c4puter/motherboard/render/B_Cu.png

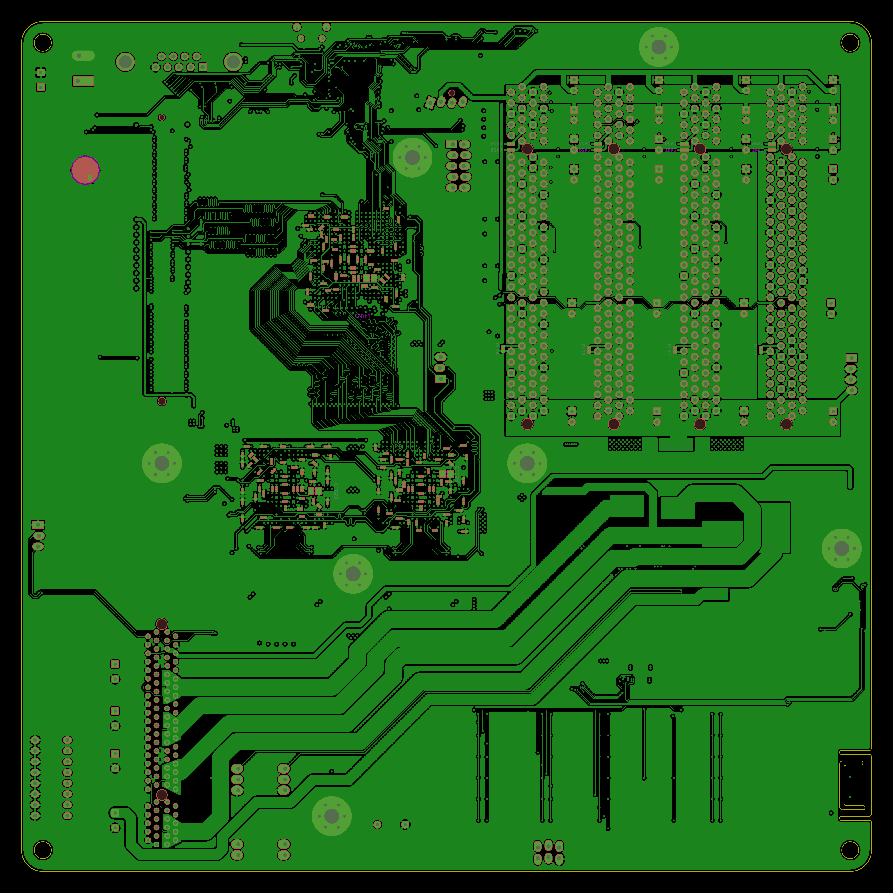
render/B_Cu.png
