c4puter/motherboard/render/F_Cu.png

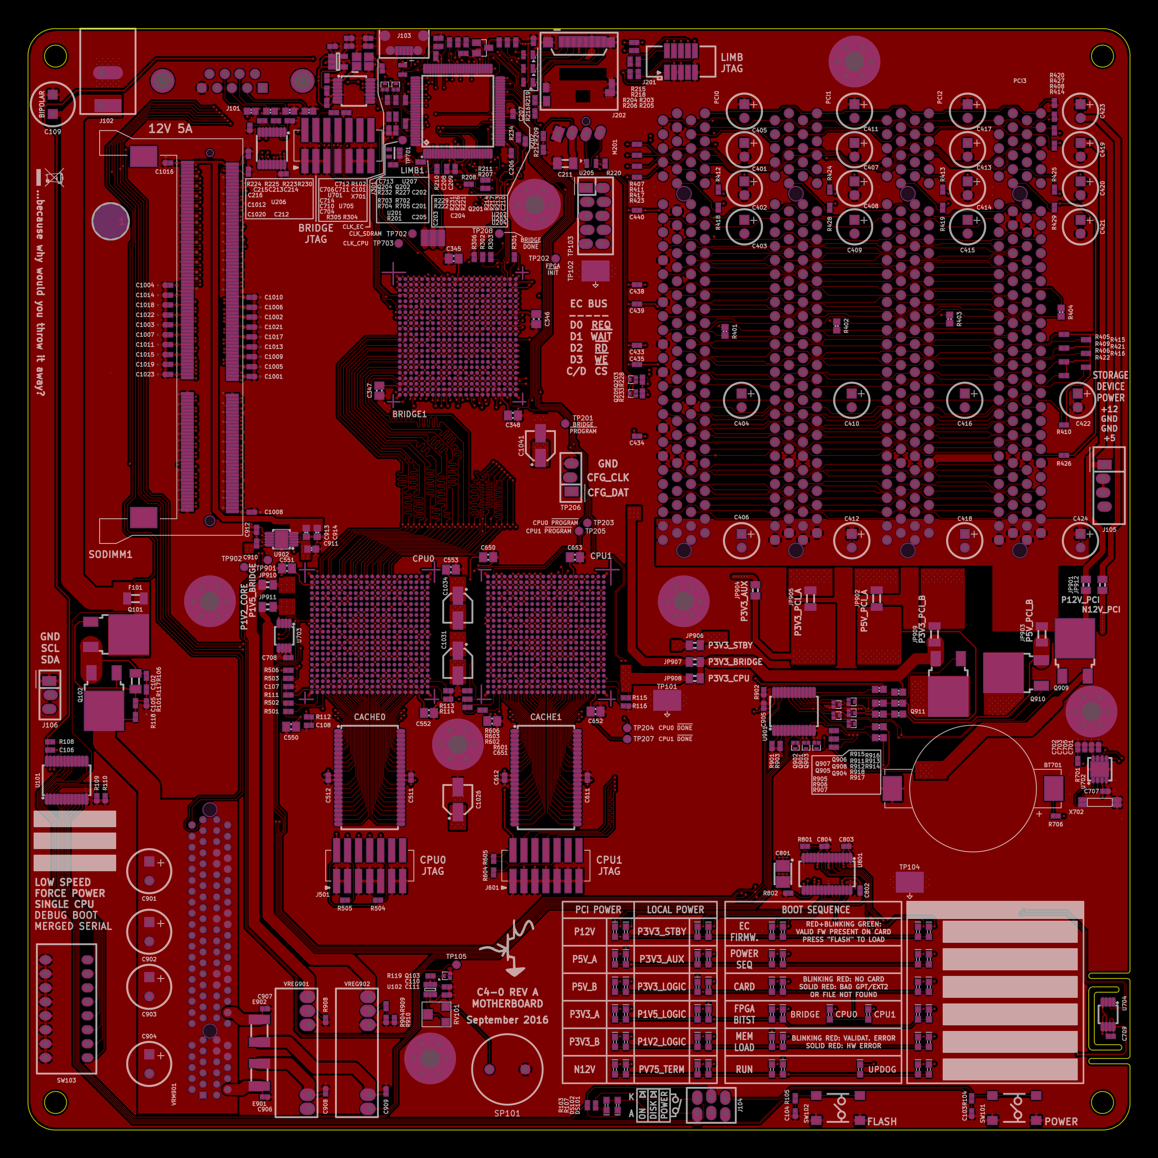
render/F_Cu.png
