c4puter/motherboard/render/In1_Cu.png

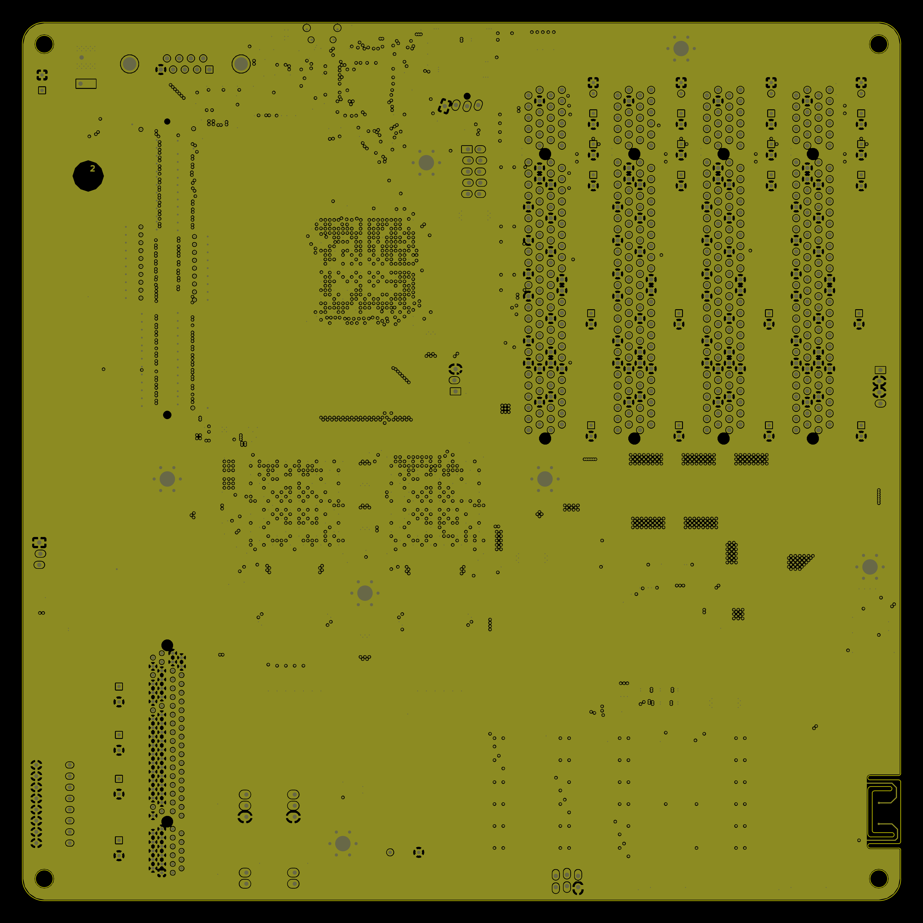
render/In1_Cu.png
