c4puter/motherboard/render/In2_Cu.png

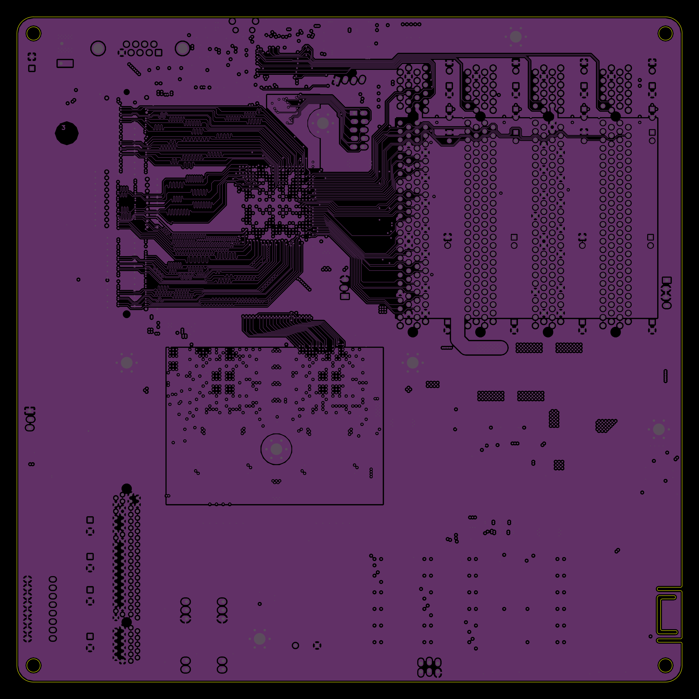
render/In2_Cu.png
