c4puter/motherboard/render/In3_Cu.png

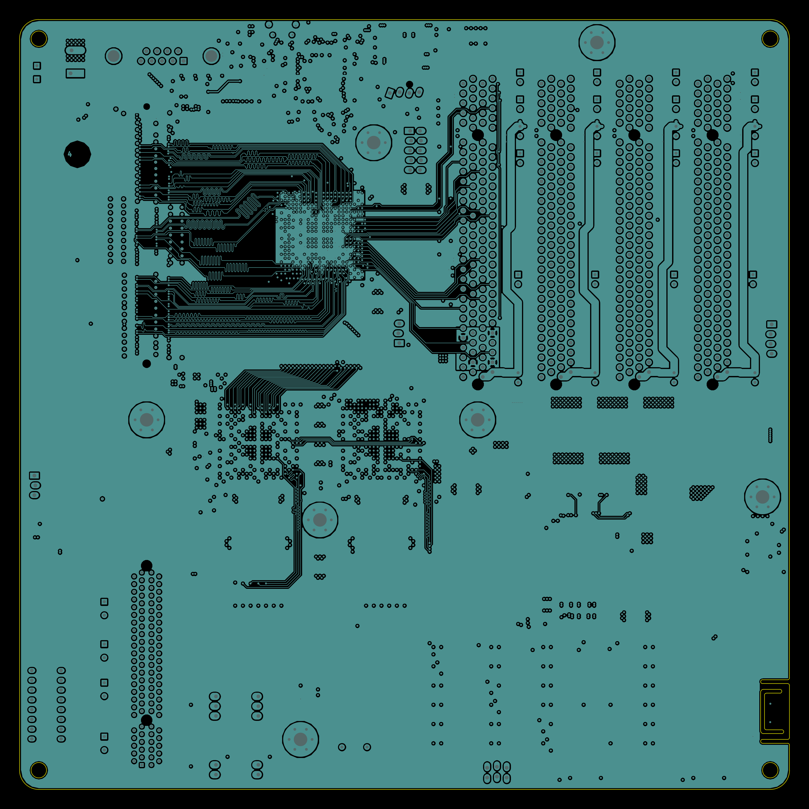
render/In3_Cu.png
