c4puter/motherboard/render/In4_Cu.png

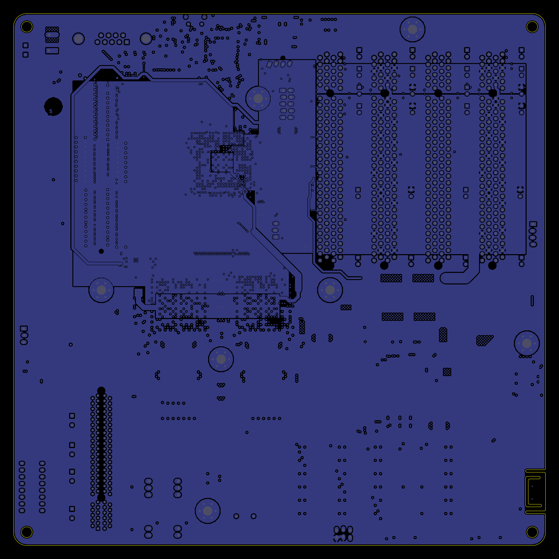
render/In4_Cu.png
