c4puter/motherboard/render/Overview.png

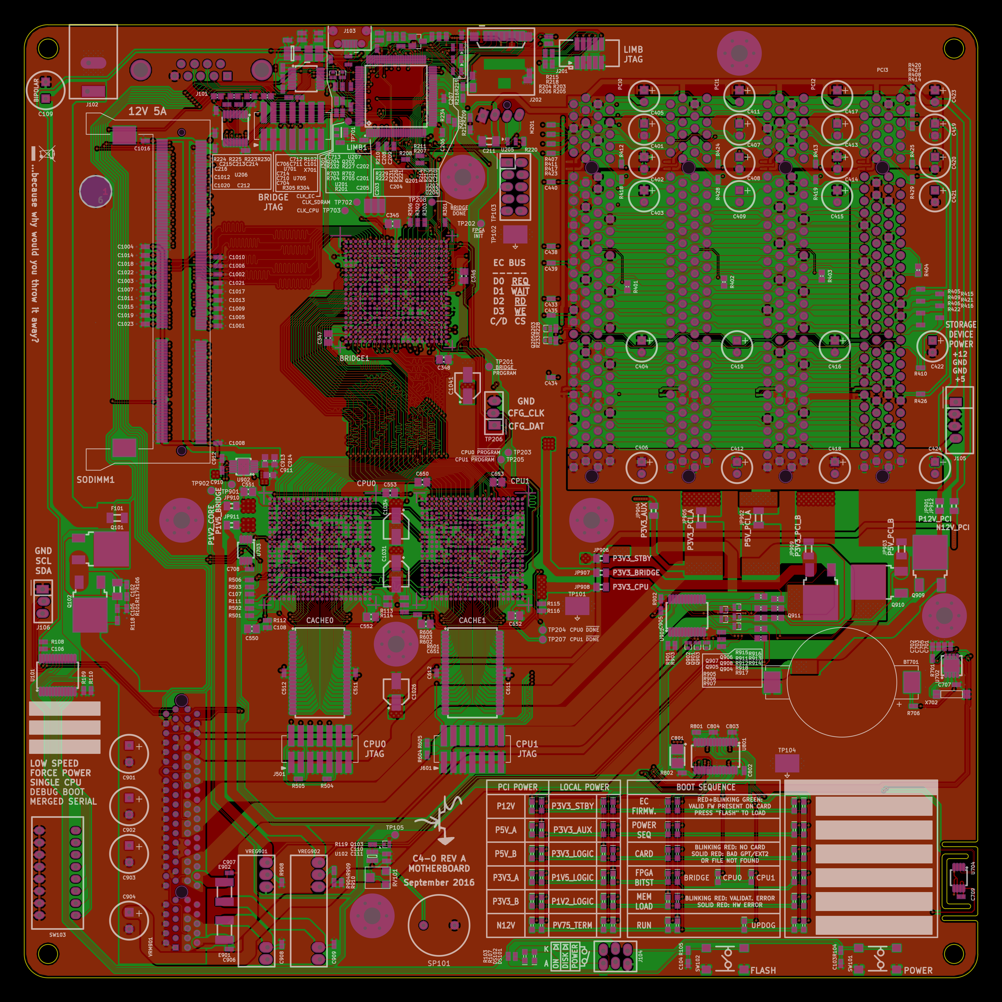
render/Overview.png
