c4puter/motherboard/motherboard.pdf

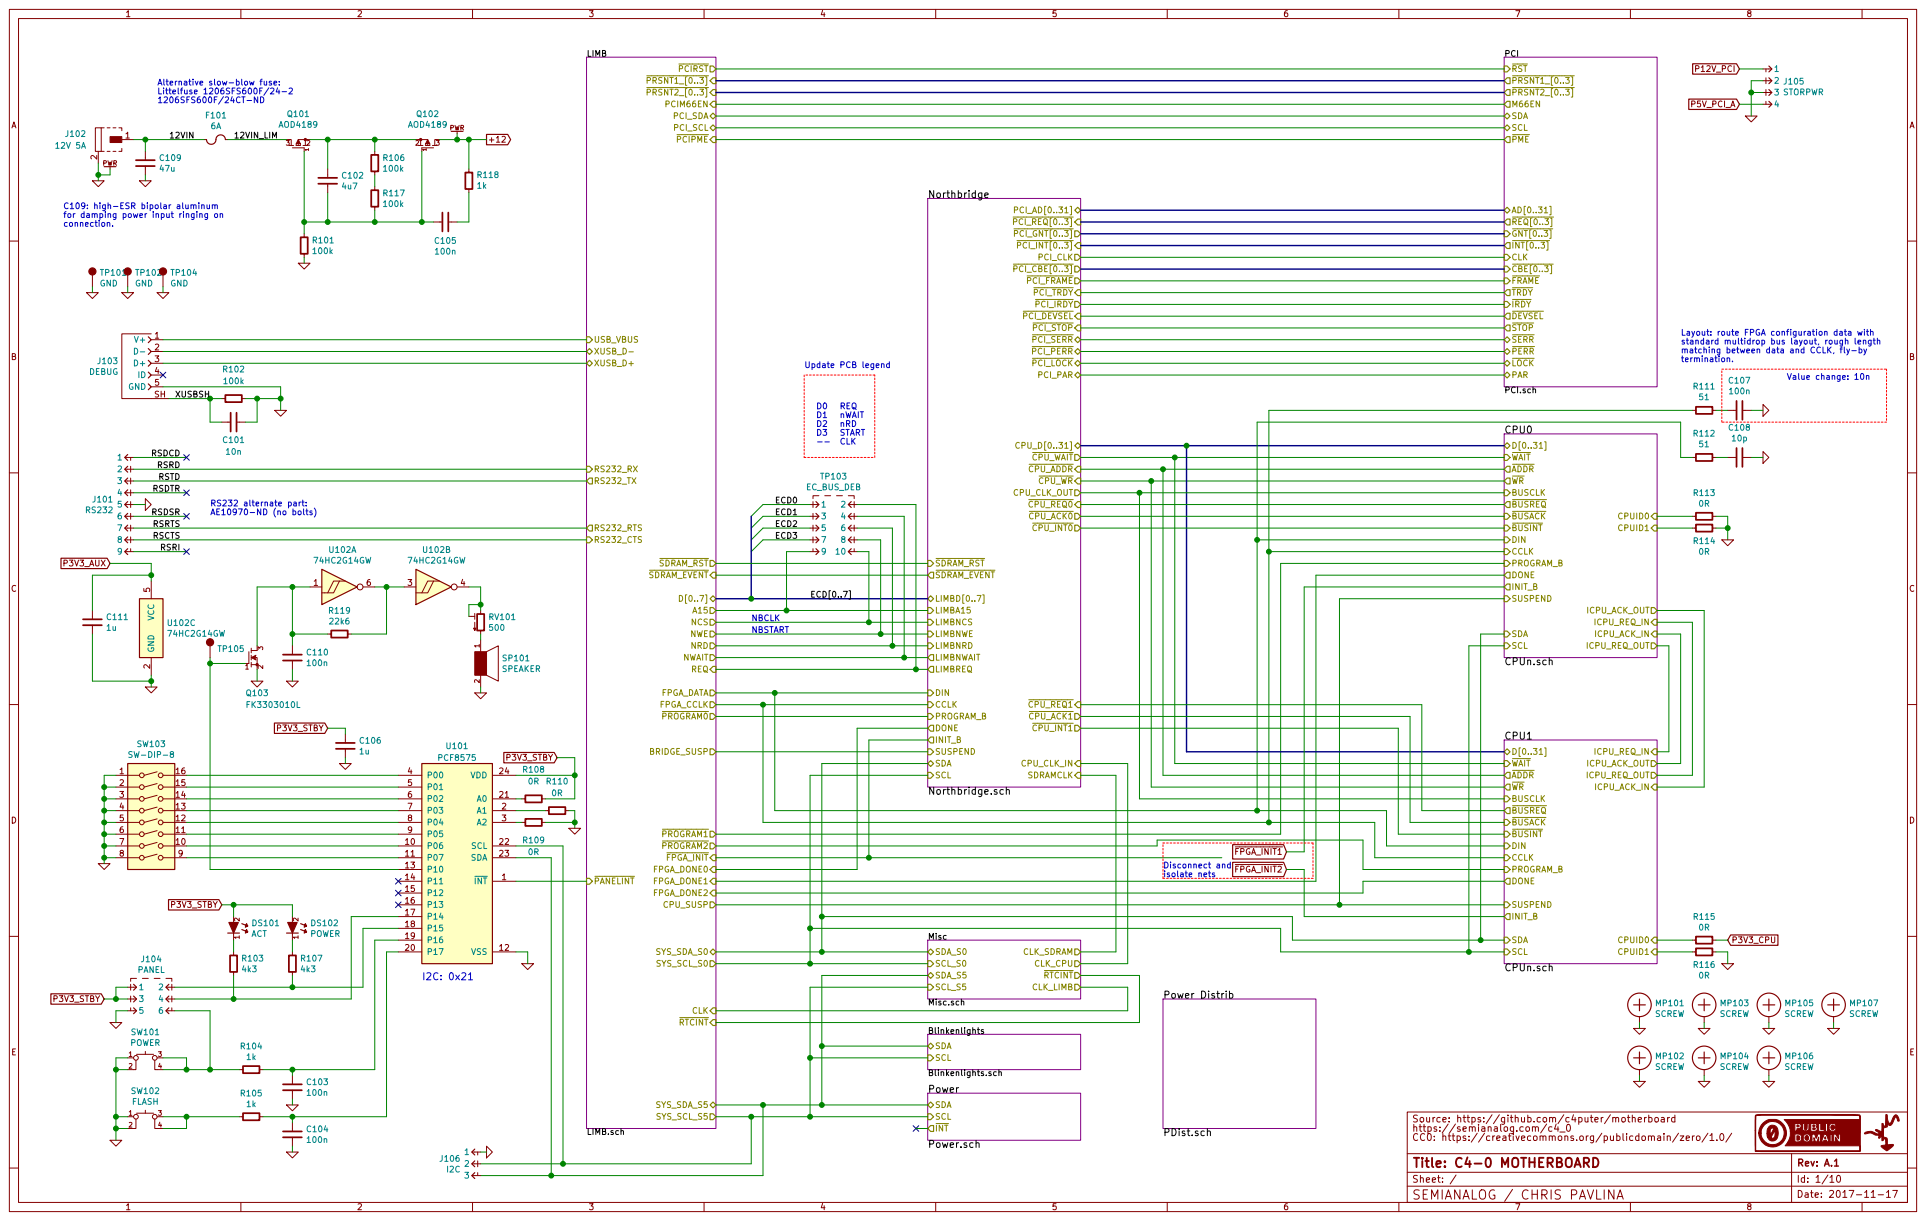
[picture p8: page 1]

PCI PCI.sch AD[0..31]
PRSNT2_[0..3] CLK RST PME CBE[0..3] FRAME
PRSNT1_[0..3]
SCL SDA M66EN CPU0

Alternative slow-blow fuse: Littelfuse 1206SFS600F/24-2
1206SFS600F/24CT-ND

47u C109: high-ESR bipolar aluminum

for damping power input ringing on

Layout: route FPGA configuration data with
standard multidrop bus layout, rough length
matching between data and CCLK, fly-by

START CLK Update PCB legend

15 | 0R 0R
14
13
12
11 | R109
10

Blinkenlights.sch SDA
SCL Power Power.sch

Source: https://github.com/c4puter/motherboard
https://semianalog.com/c4_0
Sheet: / CC0: https://creativecommons.org/publicdomain/zero/1.0/
Id: 1/10 Title: C4-0 MOTHERBOARD

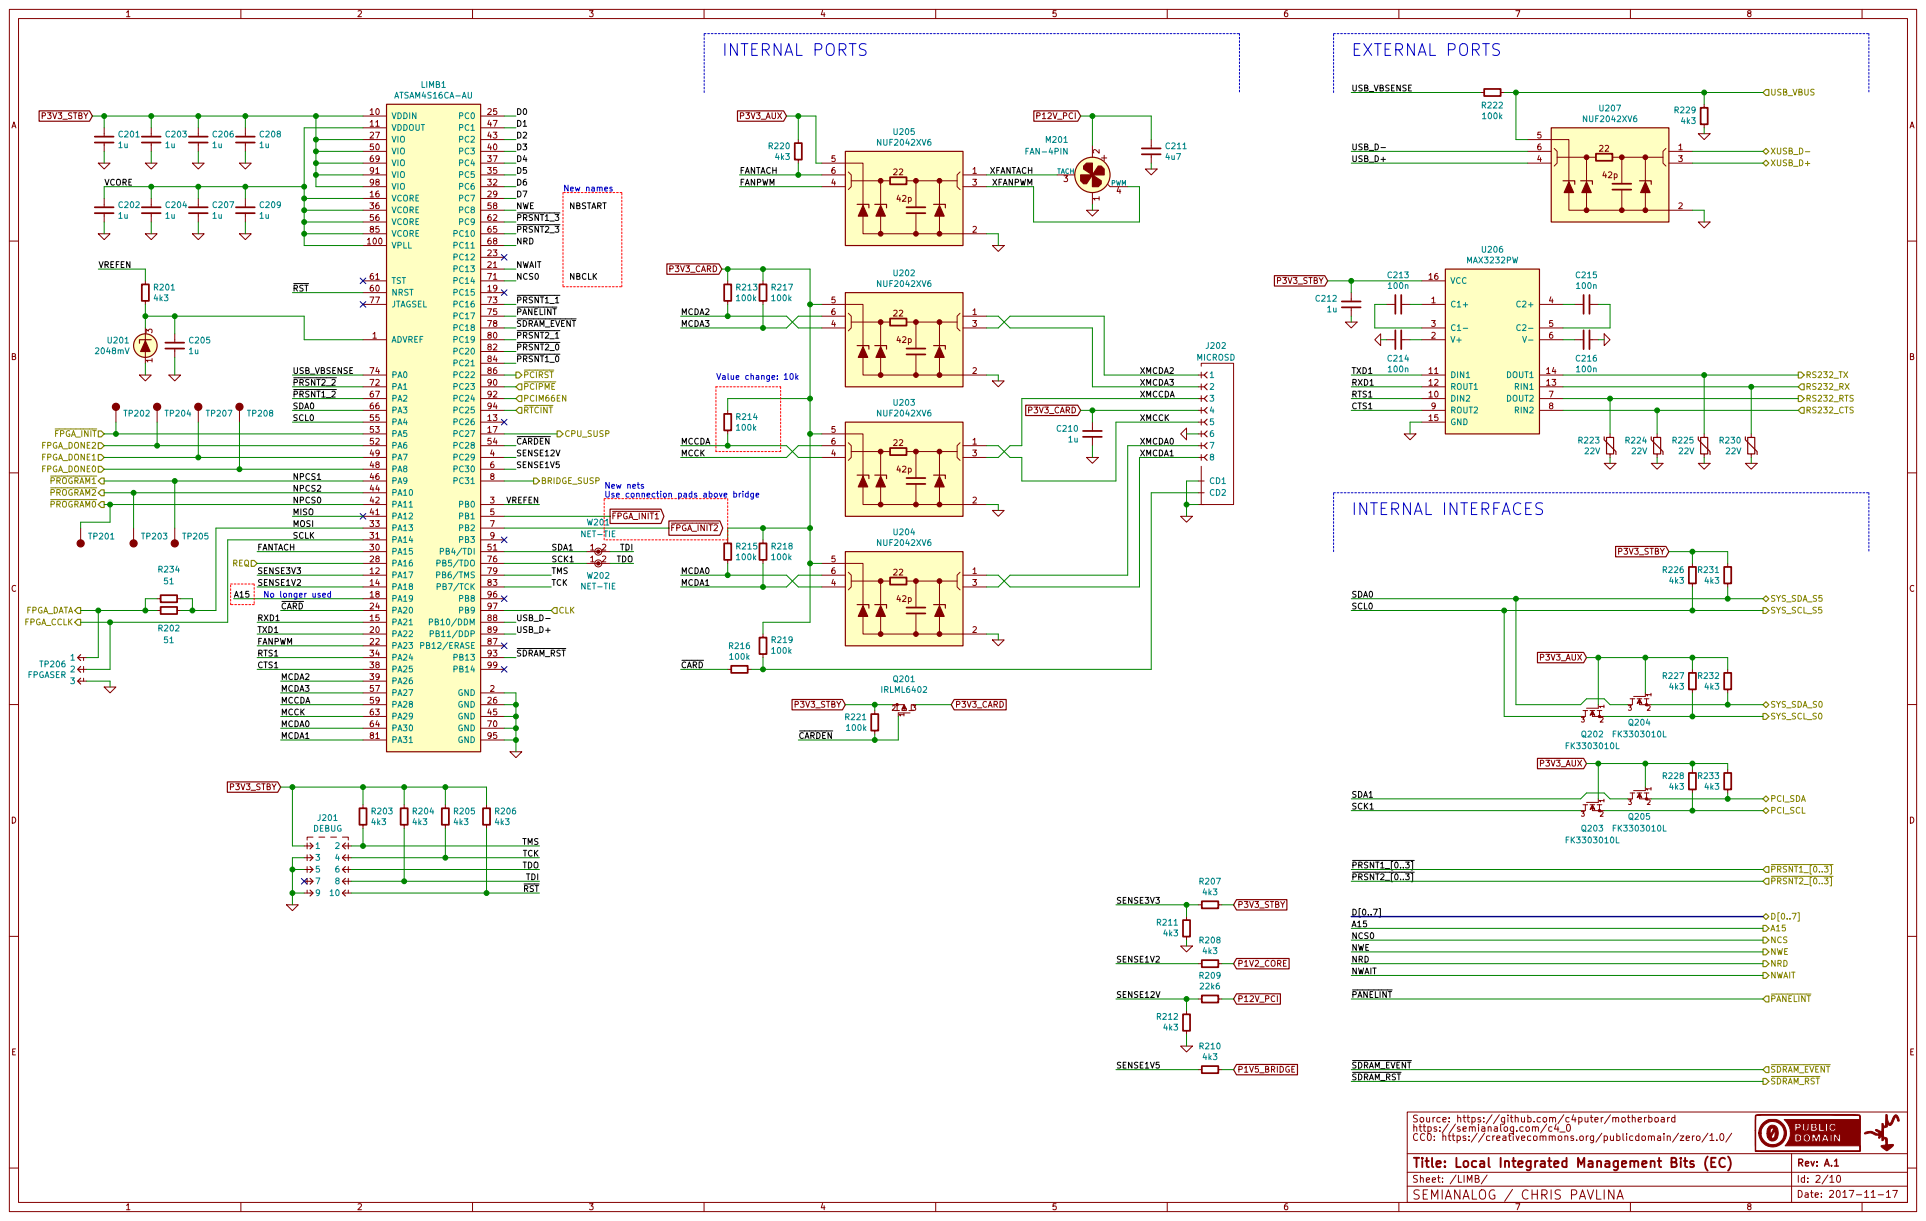
[picture p9: page 2]

Source: https://github.com/c4puter/motherboard
https://semianalog.com/c4_0
Id: 2/10 Title: Local Integrated Management Bits (EC) Sheet: /LIMB/ CC0: https://creativecommons.org/publicdomain/zero/1.0/

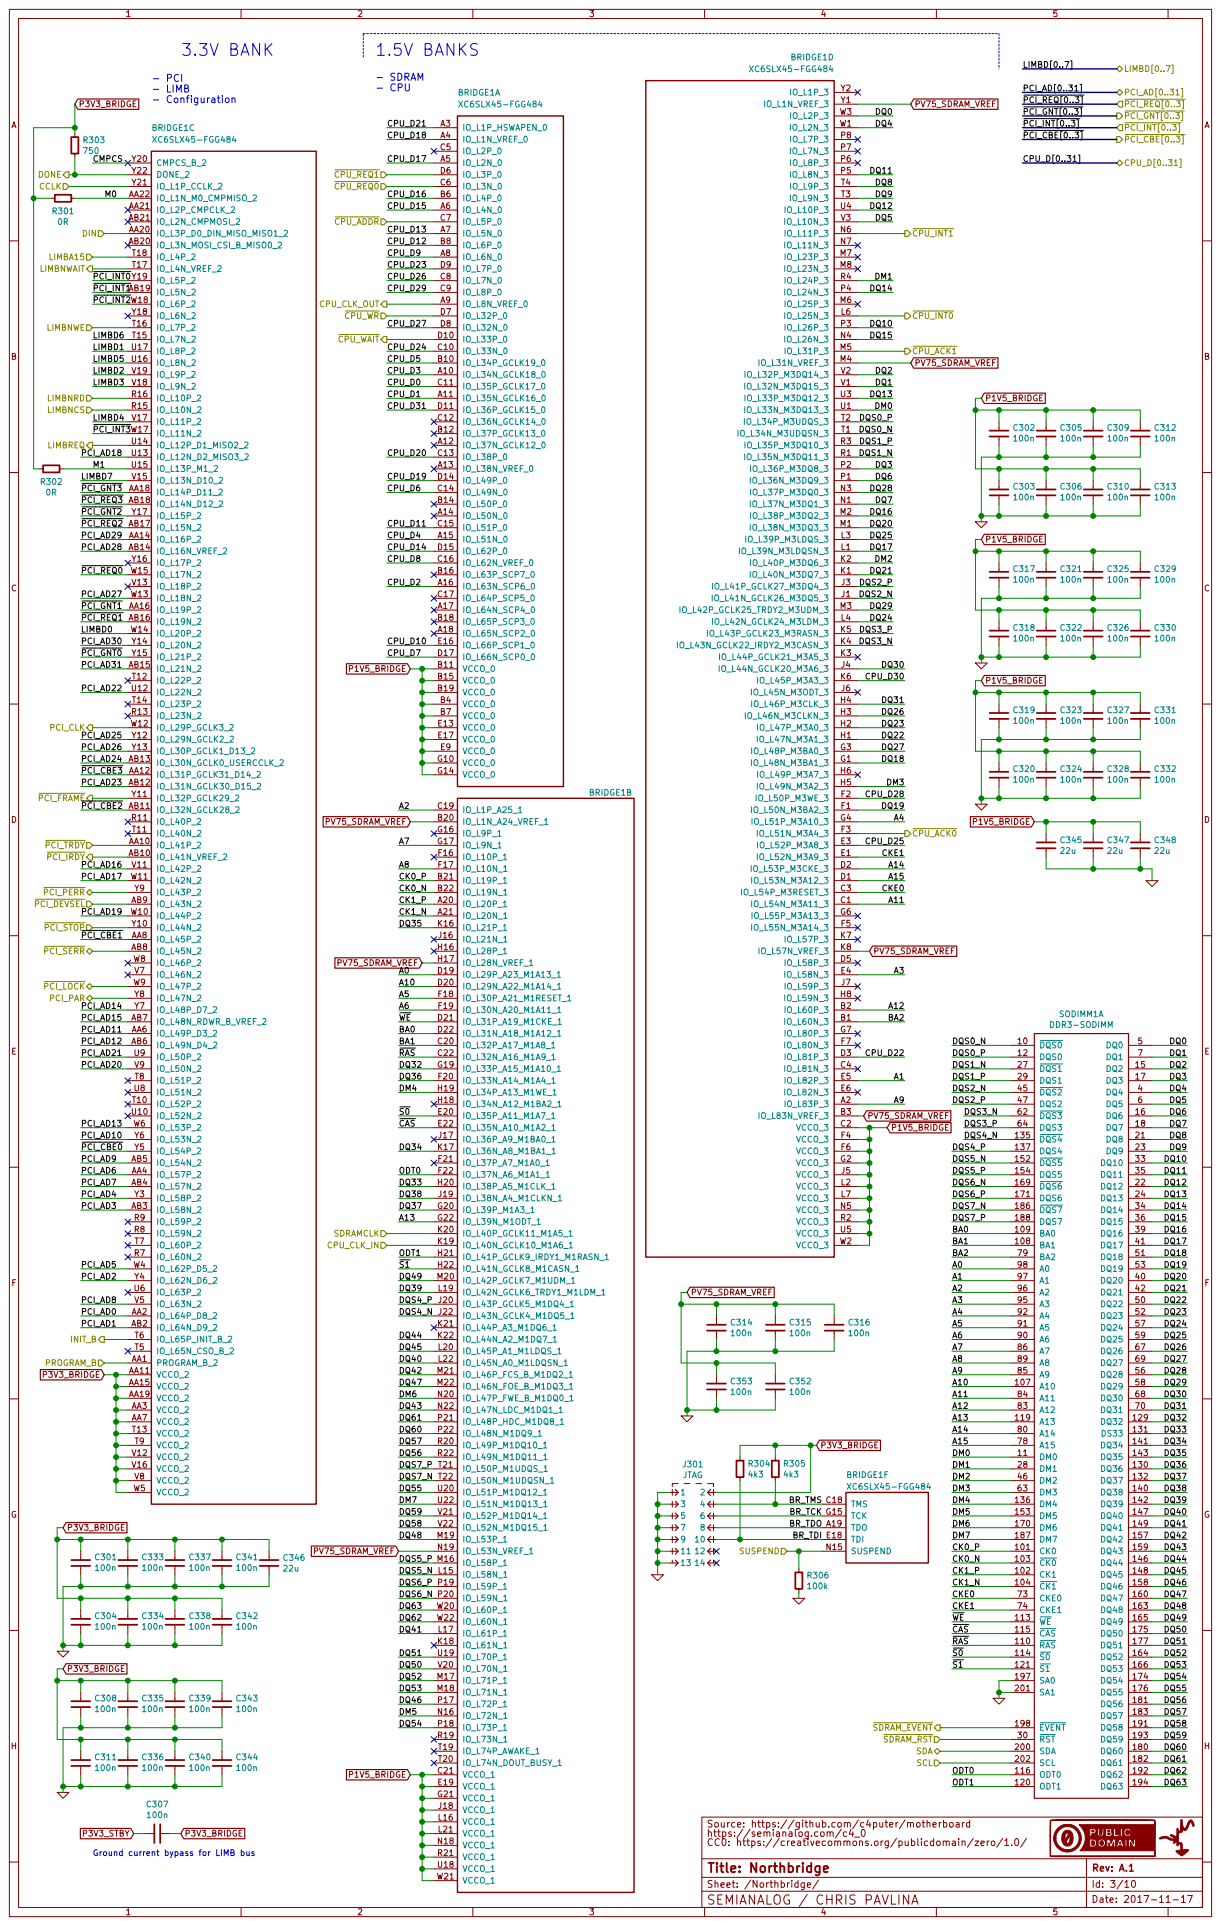
[picture p10: page 3]

TCK G15 SUSPEND N15 TMS C18 TDI E18 TDO A19 BRIDGE1F XC6SLX45-FGG484

Source: https://github.com/c4puter/motherboard
https://semianalog.com/c4_0

CC0: https://creativecommons.org/publicdomain/zero/1.0/
Id: 3/10 Title: Northbridge
Sheet: /Northbridge/

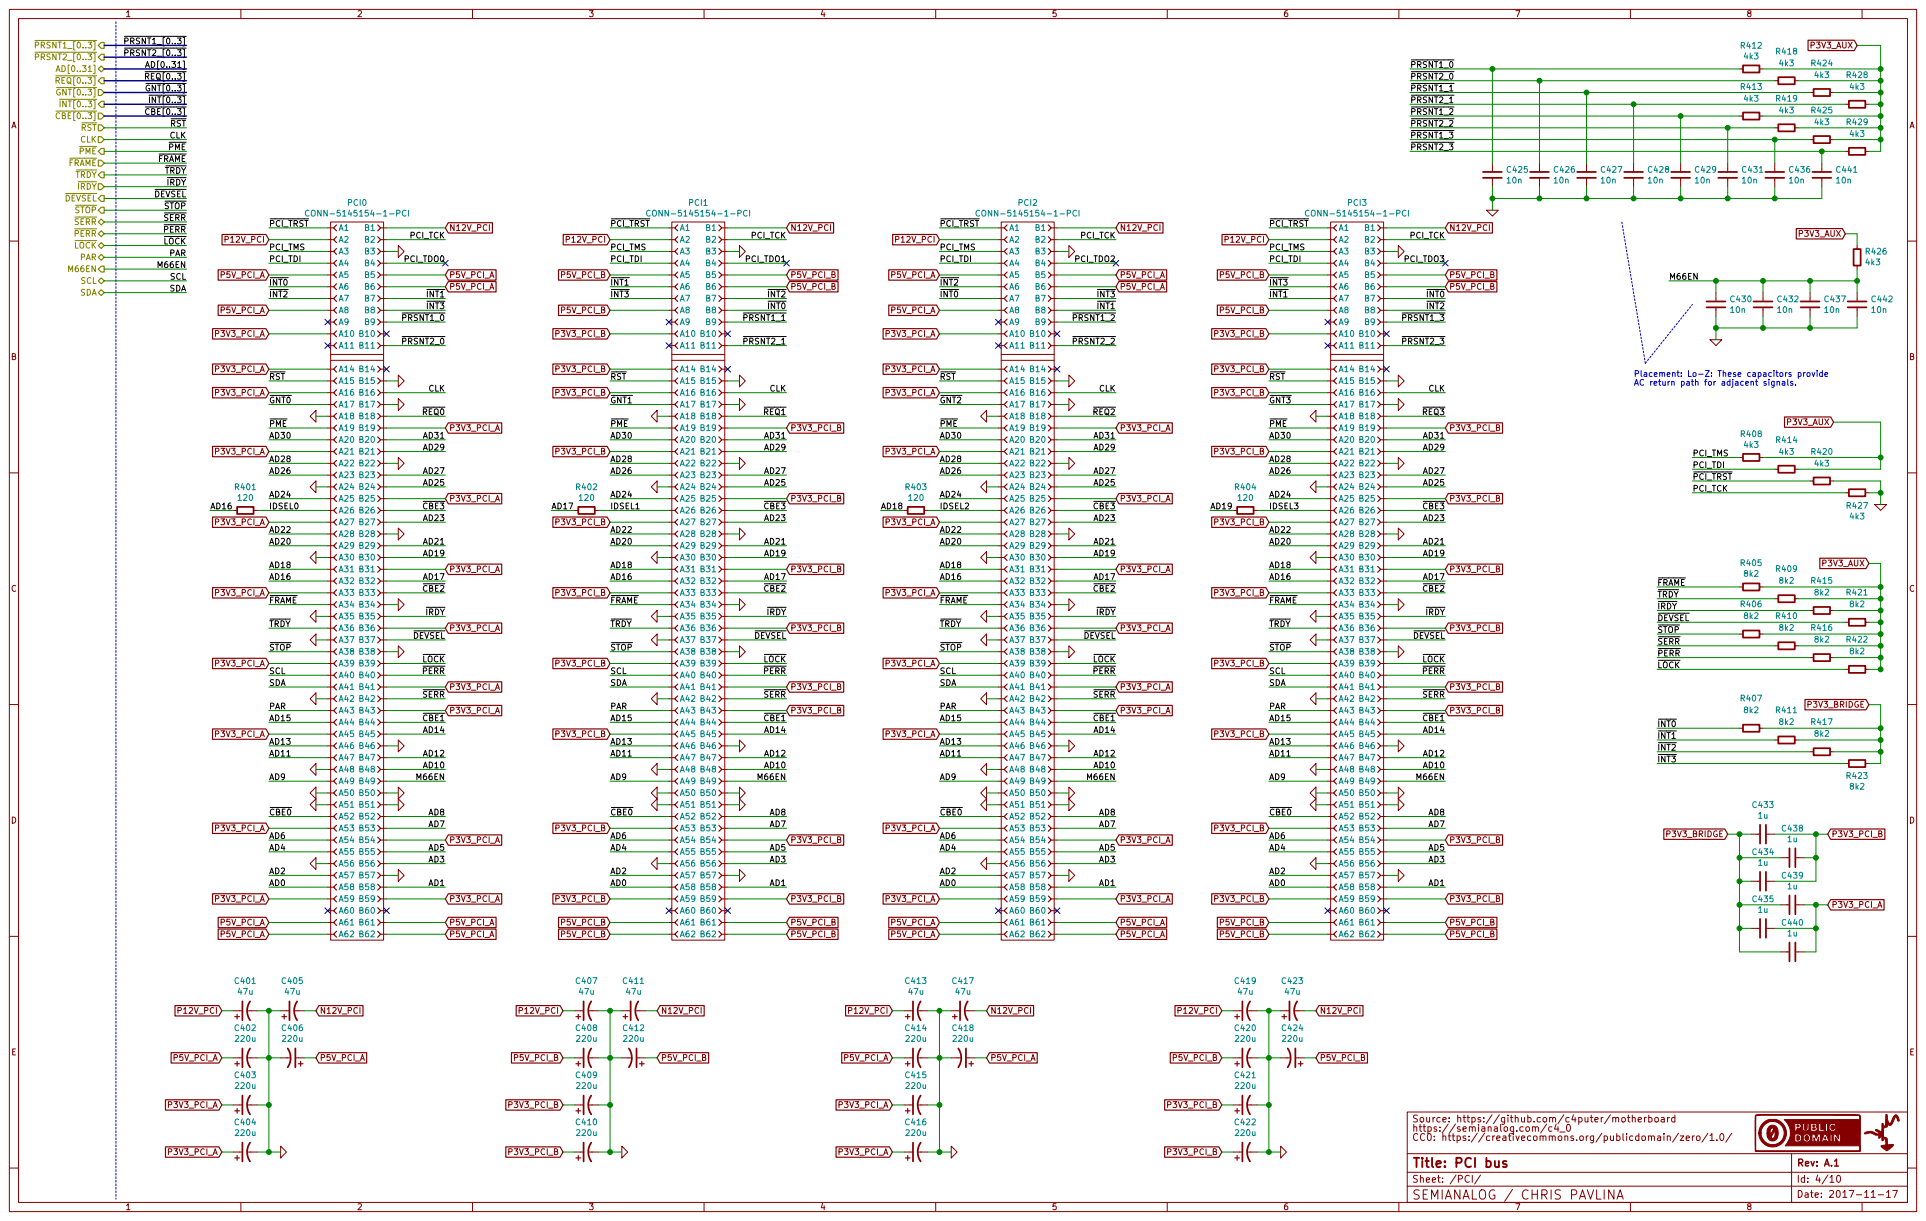
[picture p11: page 4]

P5V_PCI_B
AC return path for adjacent signals. C433

Placement: Lo-Z: These capacitors provide

Source: https://github.com/c4puter/motherboard
https://semianalog.com/c4_0
Sheet: /PCI/ CC0: https://creativecommons.org/publicdomain/zero/1.0/
Id: 4/10 Title: PCI bus

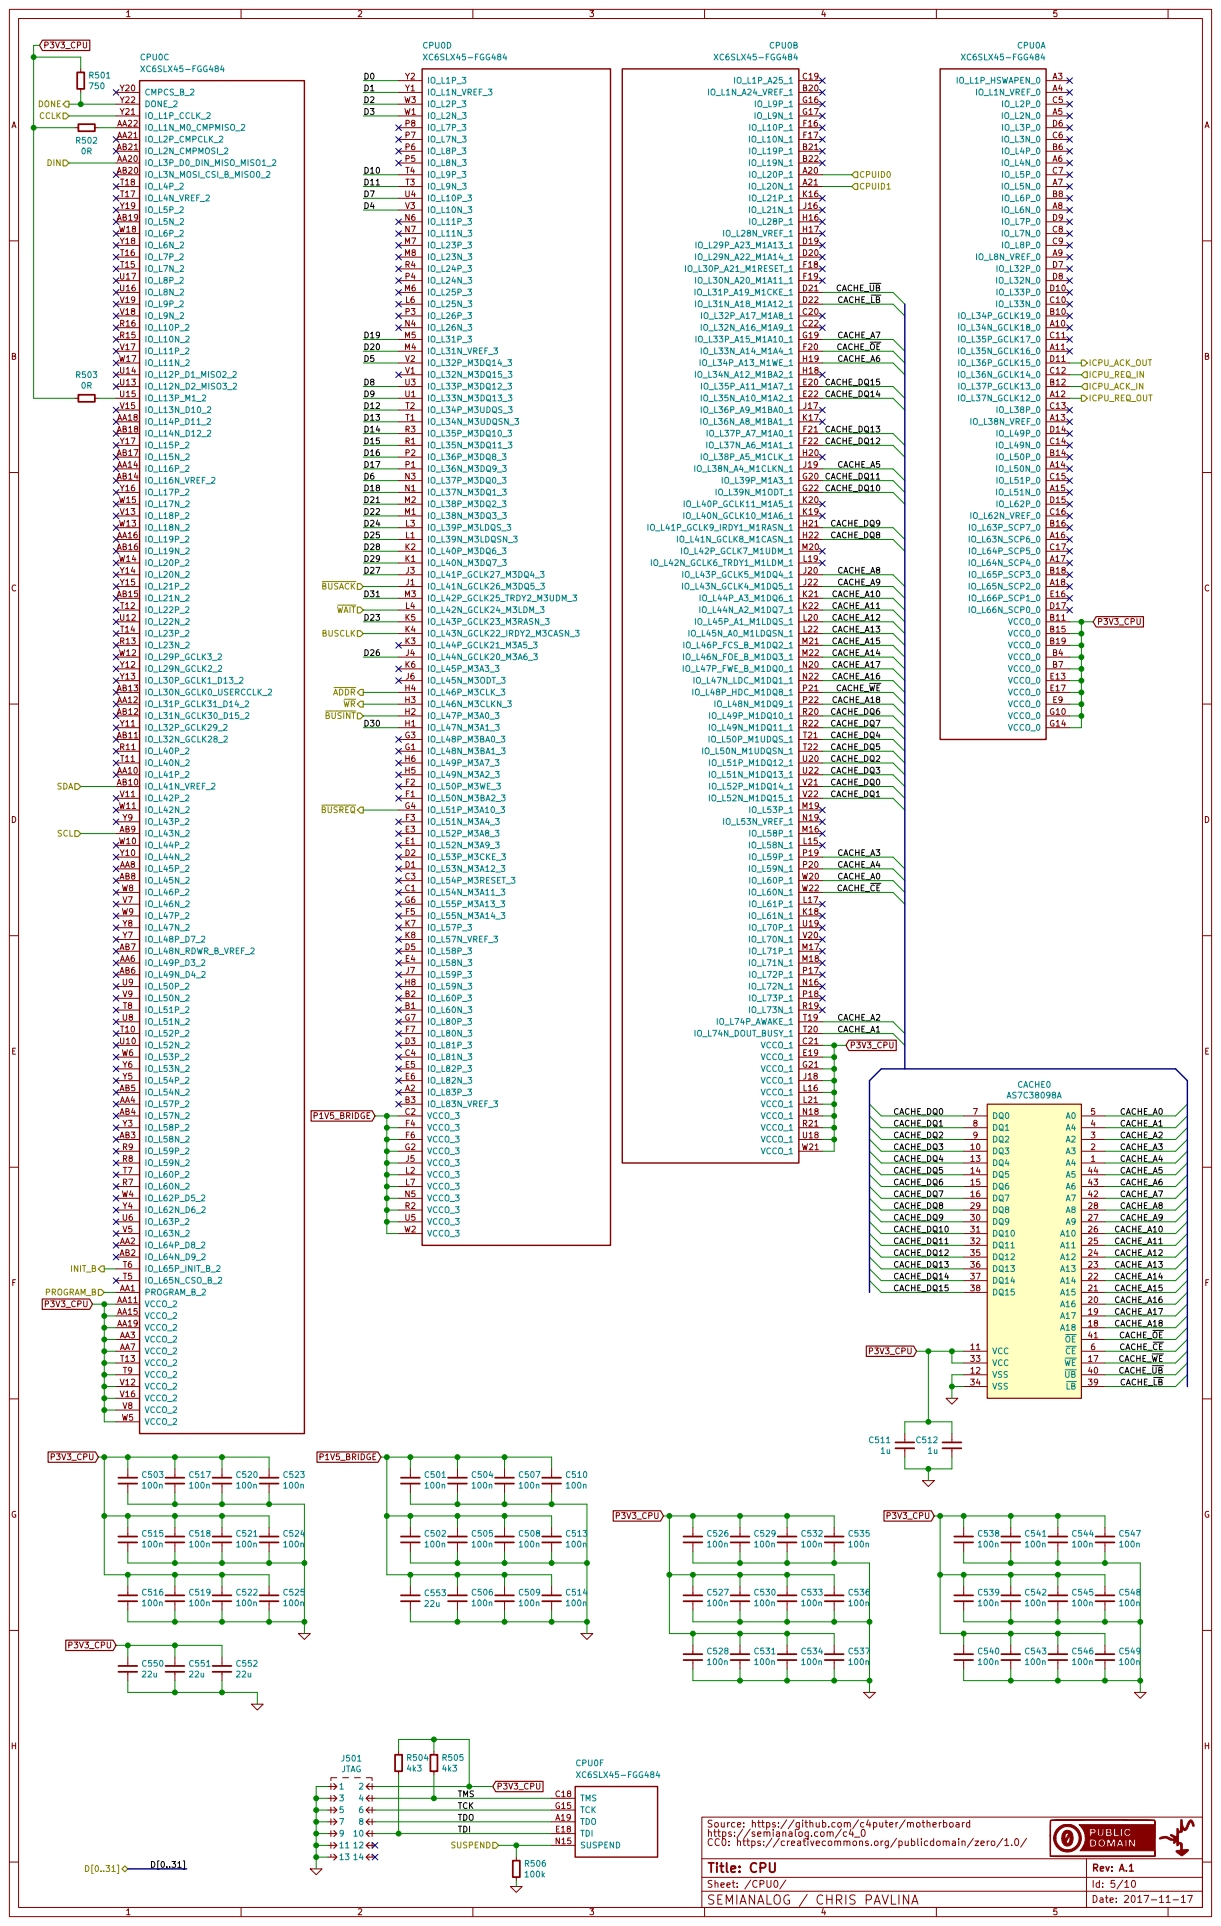
[picture p12: page 5]

Source: https://github.com/c4puter/motherboard
https://semianalog.com/c4_0
Sheet: /CPU0/ CC0: https://creativecommons.org/publicdomain/zero/1.0/
Id: 5/10 Title: CPU

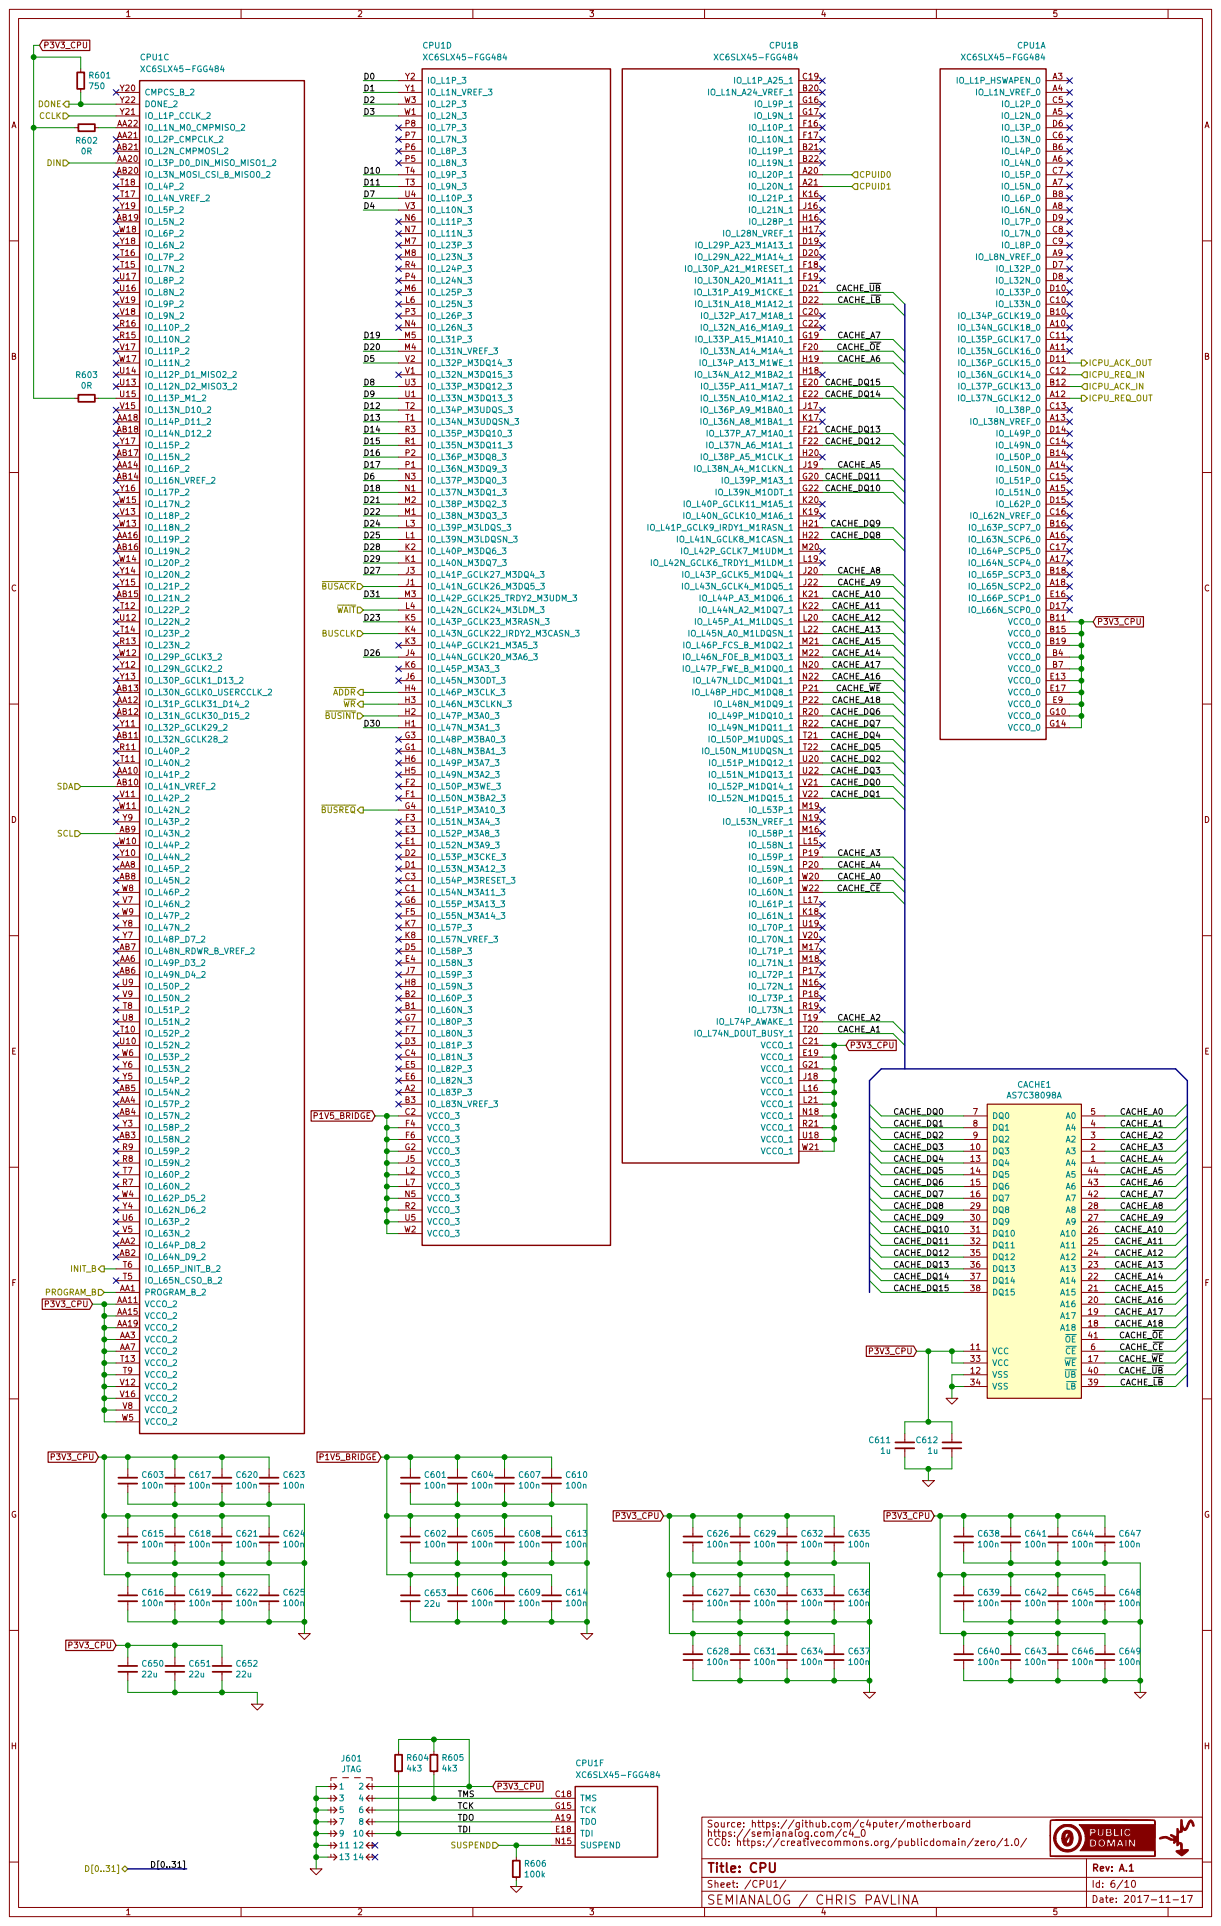
[picture p13: page 6]

Source: https://github.com/c4puter/motherboard
https://semianalog.com/c4_0
Sheet: /CPU1/ CC0: https://creativecommons.org/publicdomain/zero/1.0/
Id: 6/10 Title: CPU

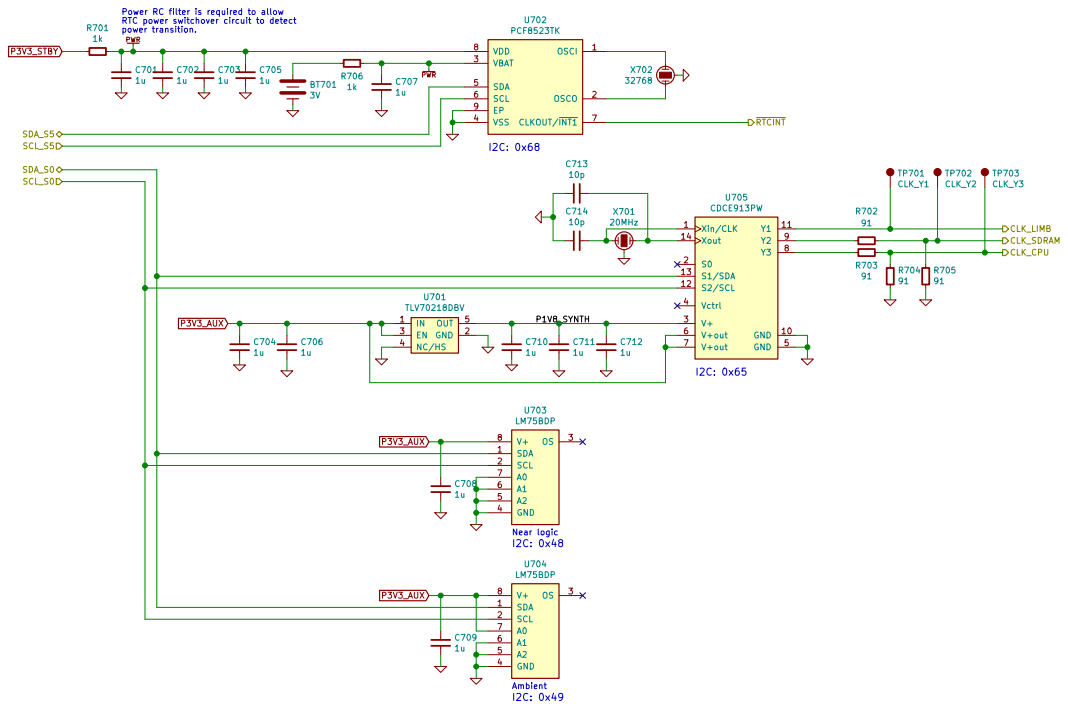
[picture p14: page 7]

Power RC filter is required to allow
RTC power switchover circuit to detect

Source: https://github.com/c4puter/motherboard
https://semianalog.com/c4_0
Sheet: /Misc/ CC0: https://creativecommons.org/publicdomain/zero/1.0/
Id: 7/10 Title: Miscellaneous peripherals

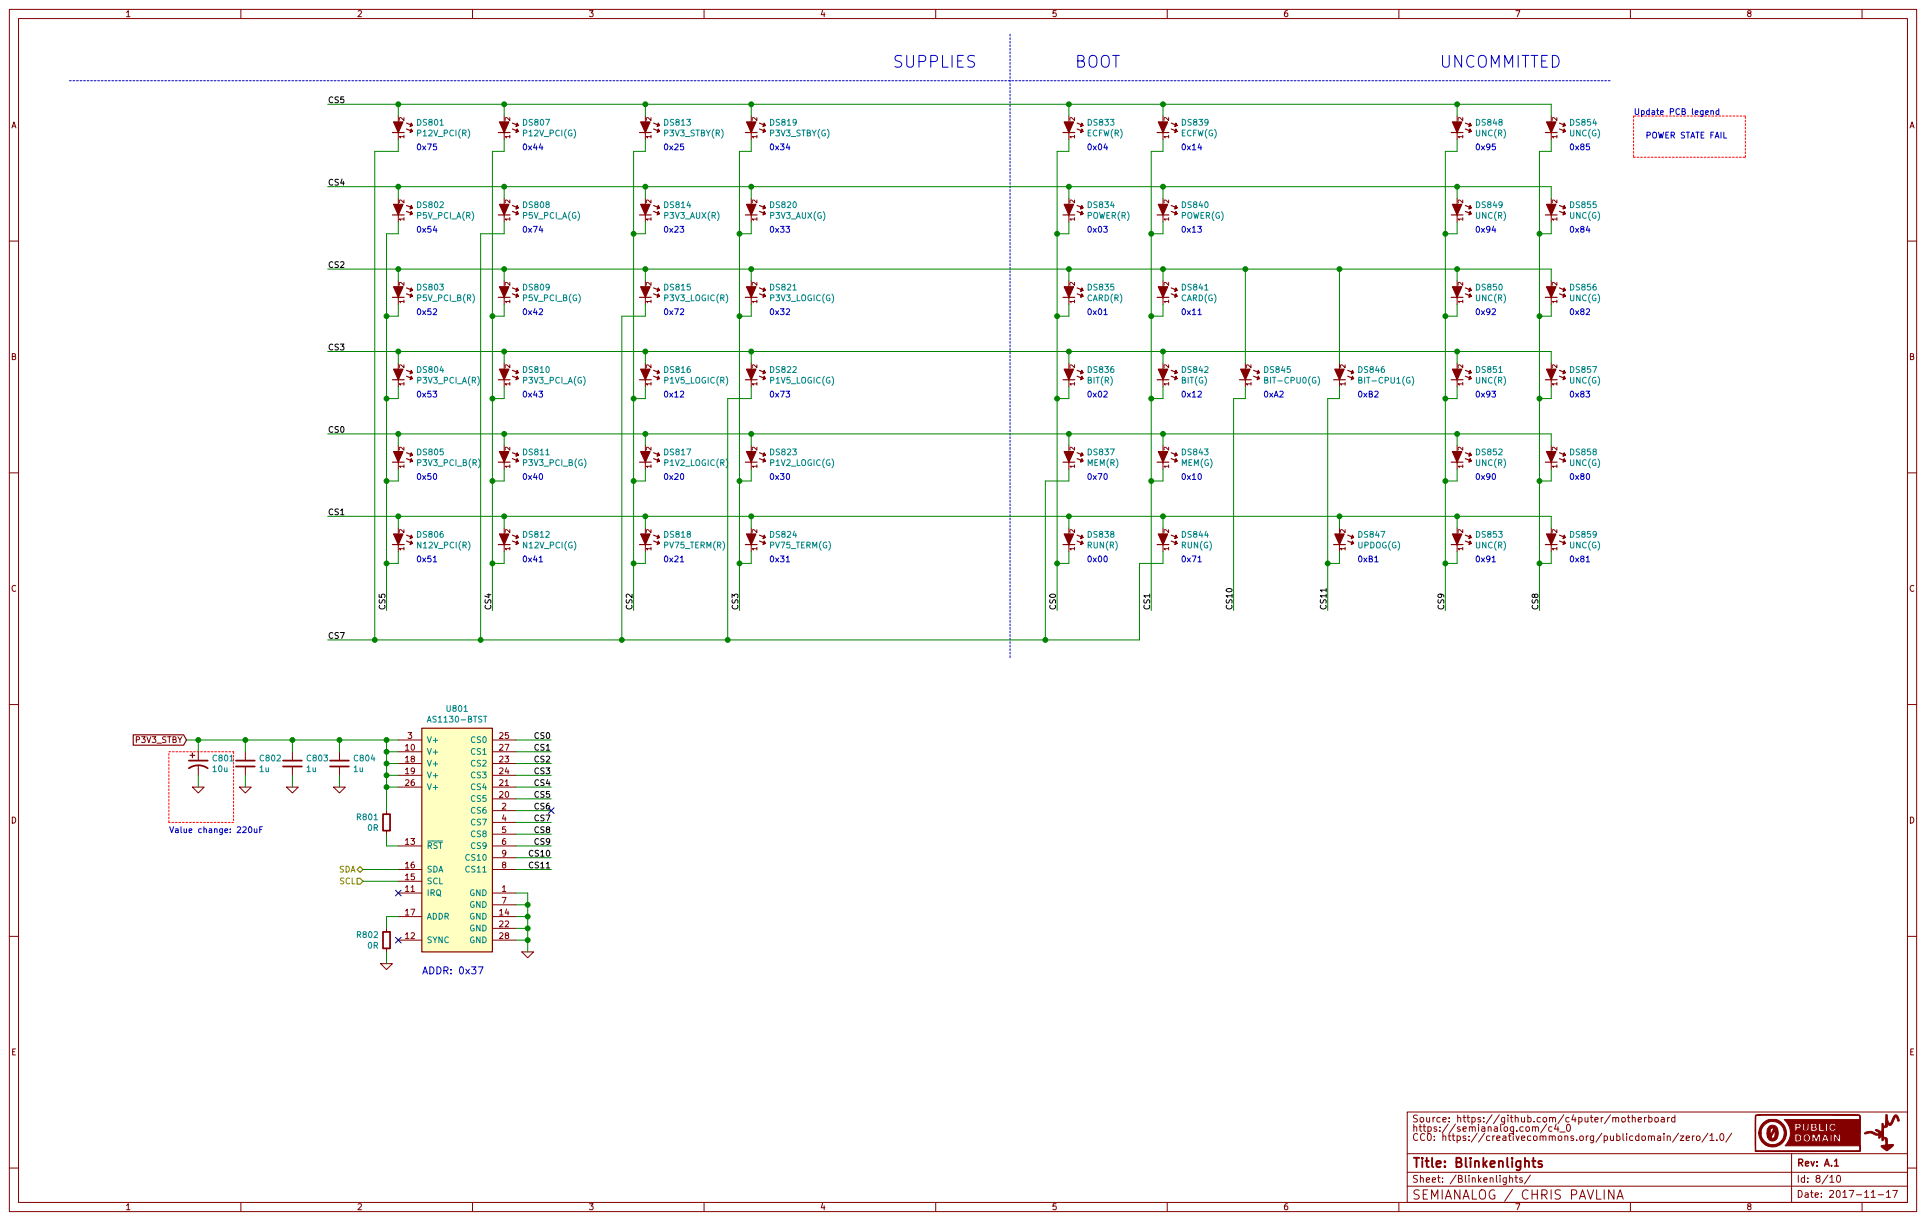
[picture p15: page 8]

POWER STATE FAIL Update PCB legend

1 2DS848 UNC(R) 1 2DS854 UNC(G) 1 2DS849 UNC(R) 1 2DS855 UNC(G) 1 2DS850 UNC(R) 1 2DS856 UNC(G) 1 2DS851 UNC(R) 1 2DS857 UNC(G) 1 2DS852 UNC(R) 1 2DS858 UNC(G) 1 2DS853 UNC(R) 1 2DS859 UNC(G) SDA

1 2DS833 ECFW(R) 1 2DS839 ECFW(G) 1 2DS834 POWER(R) 1 2DS840 POWER(G) 1 2DS835 CARD(R) 1 2DS841 CARD(G) 1 2DS845 BIT-CPU0(G) 1 2DS846 BIT-CPU1(G) 1 2DS836 BIT(R) 1 2DS842 BIT(G) 1 2DS837 MEM(R) 1 2DS843 MEM(G) 1 2DS847 UPDOG(G) 1 2DS838 RUN(R) 1 2DS844 RUN(G)

Source: https://github.com/c4puter/motherboard
https://semianalog.com/c4_0

CC0: https://creativecommons.org/publicdomain/zero/1.0/
Id: 8/10 Title: Blinkenlights
Sheet: /Blinkenlights/

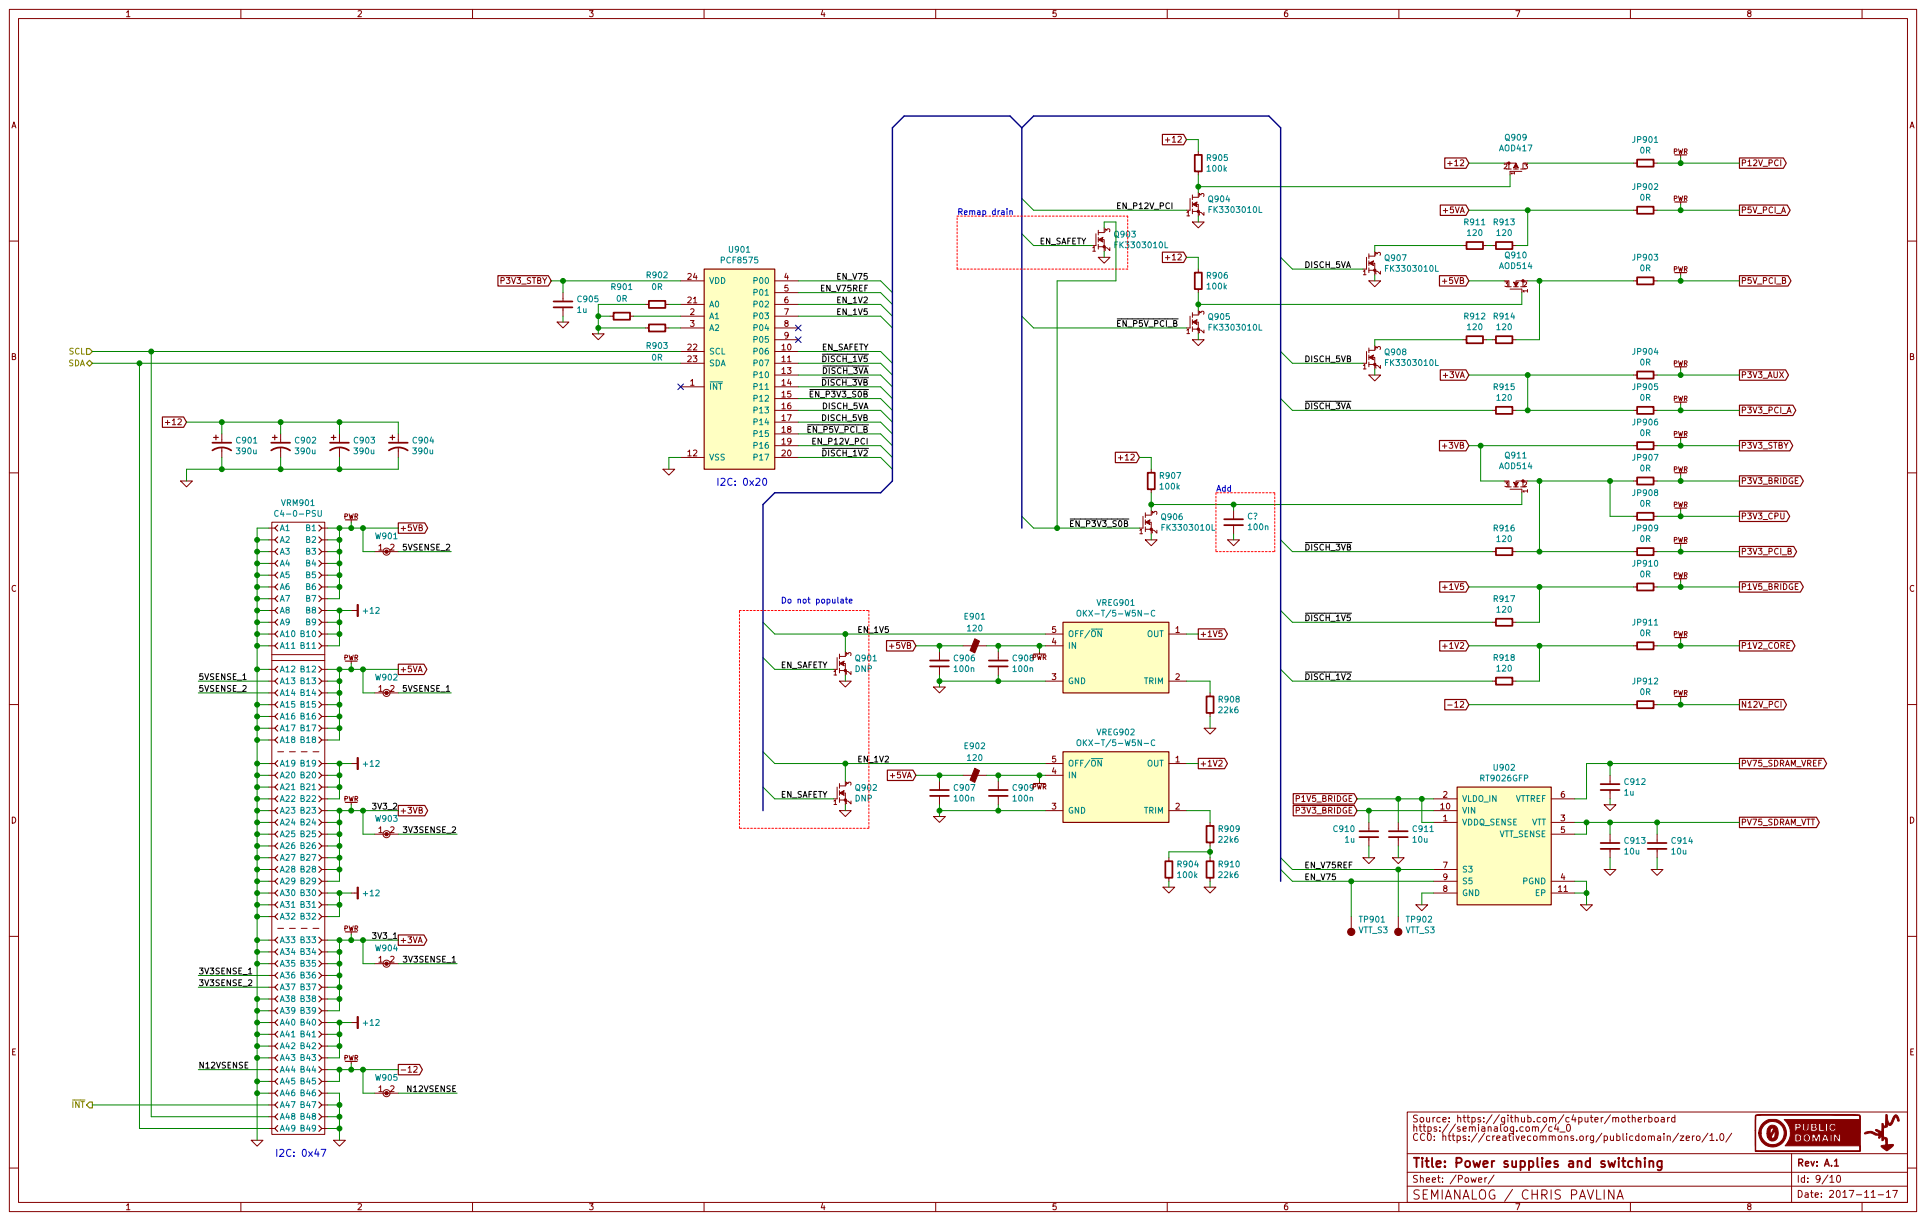
[picture p16: page 9]

Source: https://github.com/c4puter/motherboard
https://semianalog.com/c4_0
Sheet: /Power/ CC0: https://creativecommons.org/publicdomain/zero/1.0/
Id: 9/10 Title: Power supplies and switching

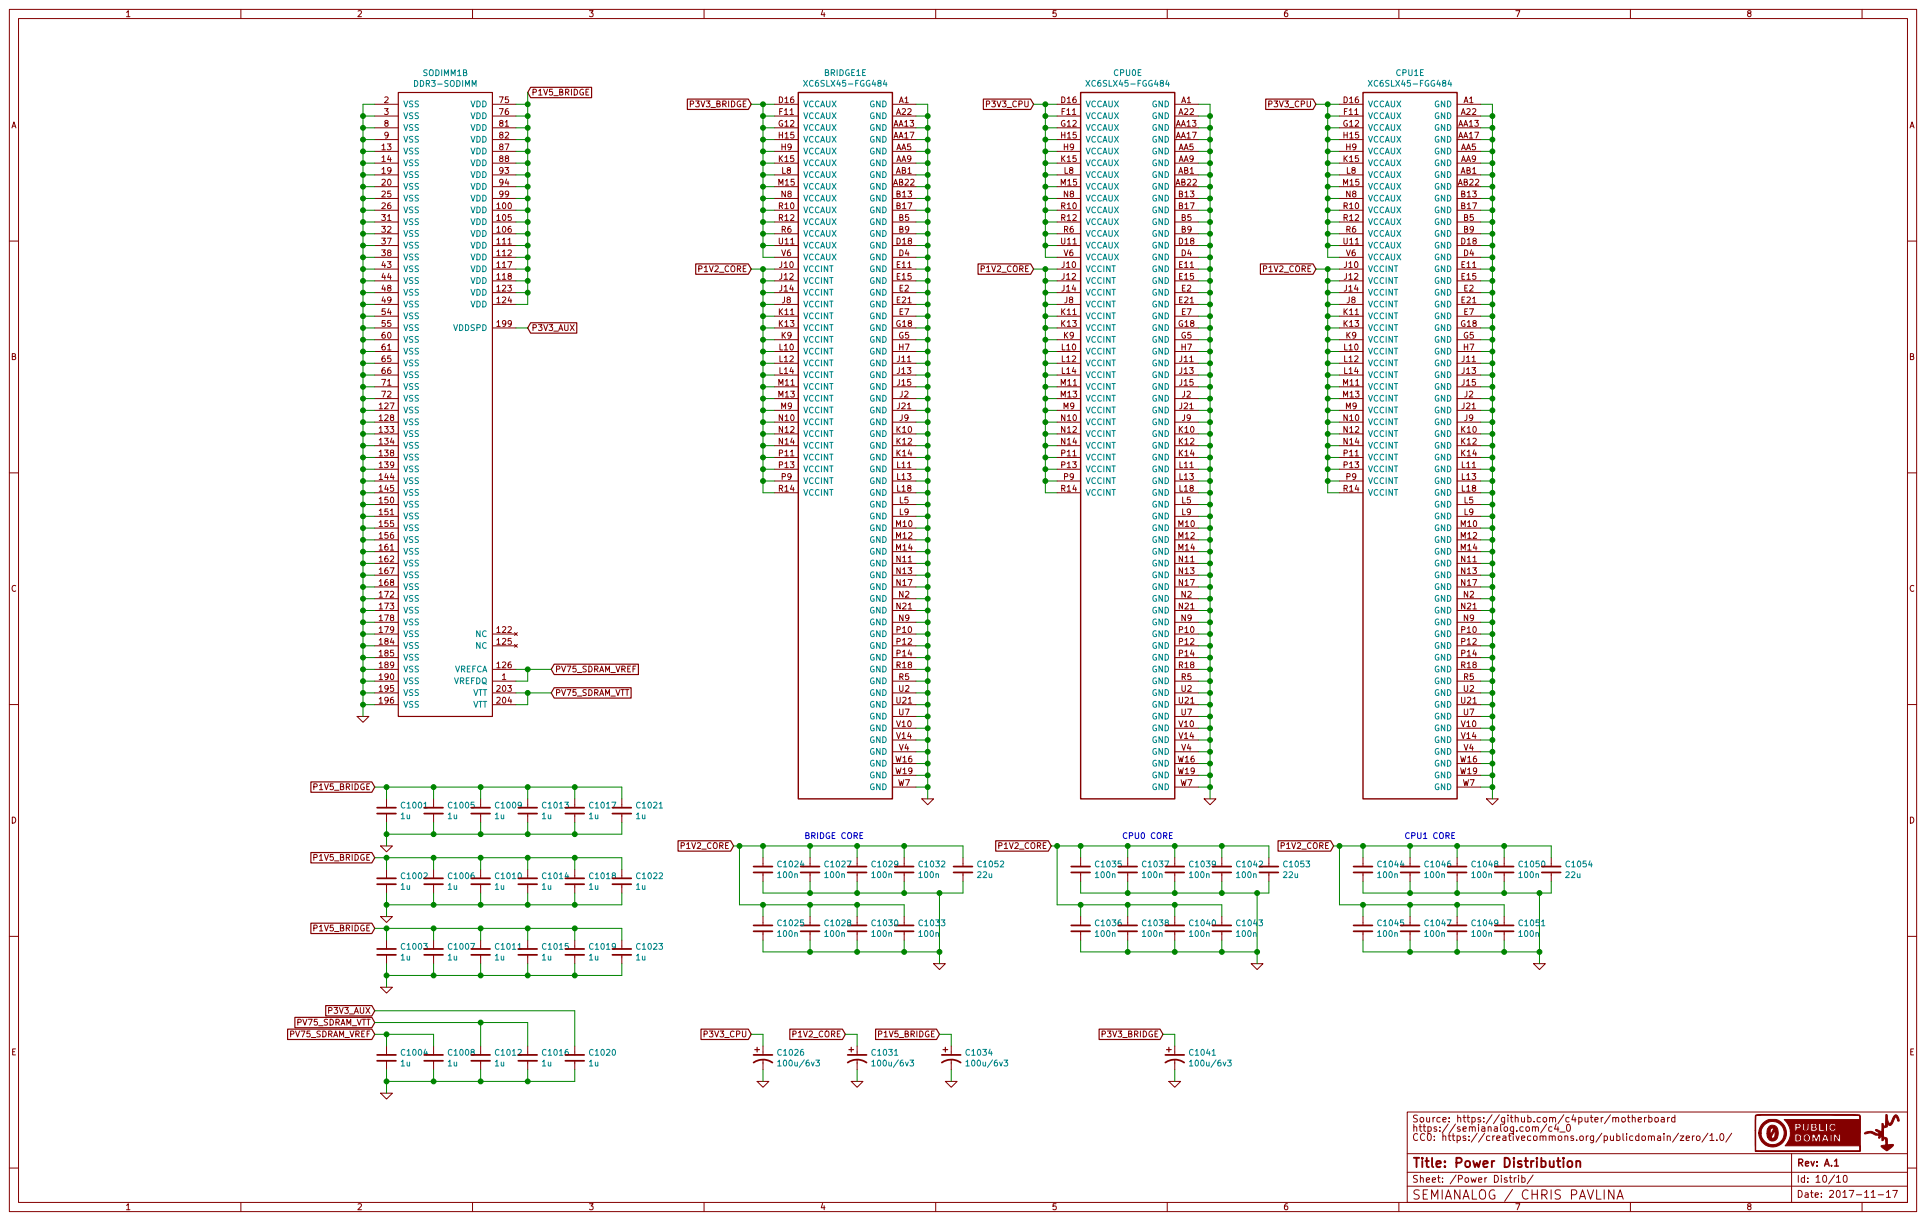
[picture p17: page 10]

Source: https://github.com/c4puter/motherboard
https://semianalog.com/c4_0
Sheet: /Power Distrib/ CC0: https://creativecommons.org/publicdomain/zero/1.0/
Id: 10/10 Title: Power Distribution
