c4puter/motherboard/c4puter.kicad_pcb

## KiCad design c4puter.kicad_pcb (2016-08-05)

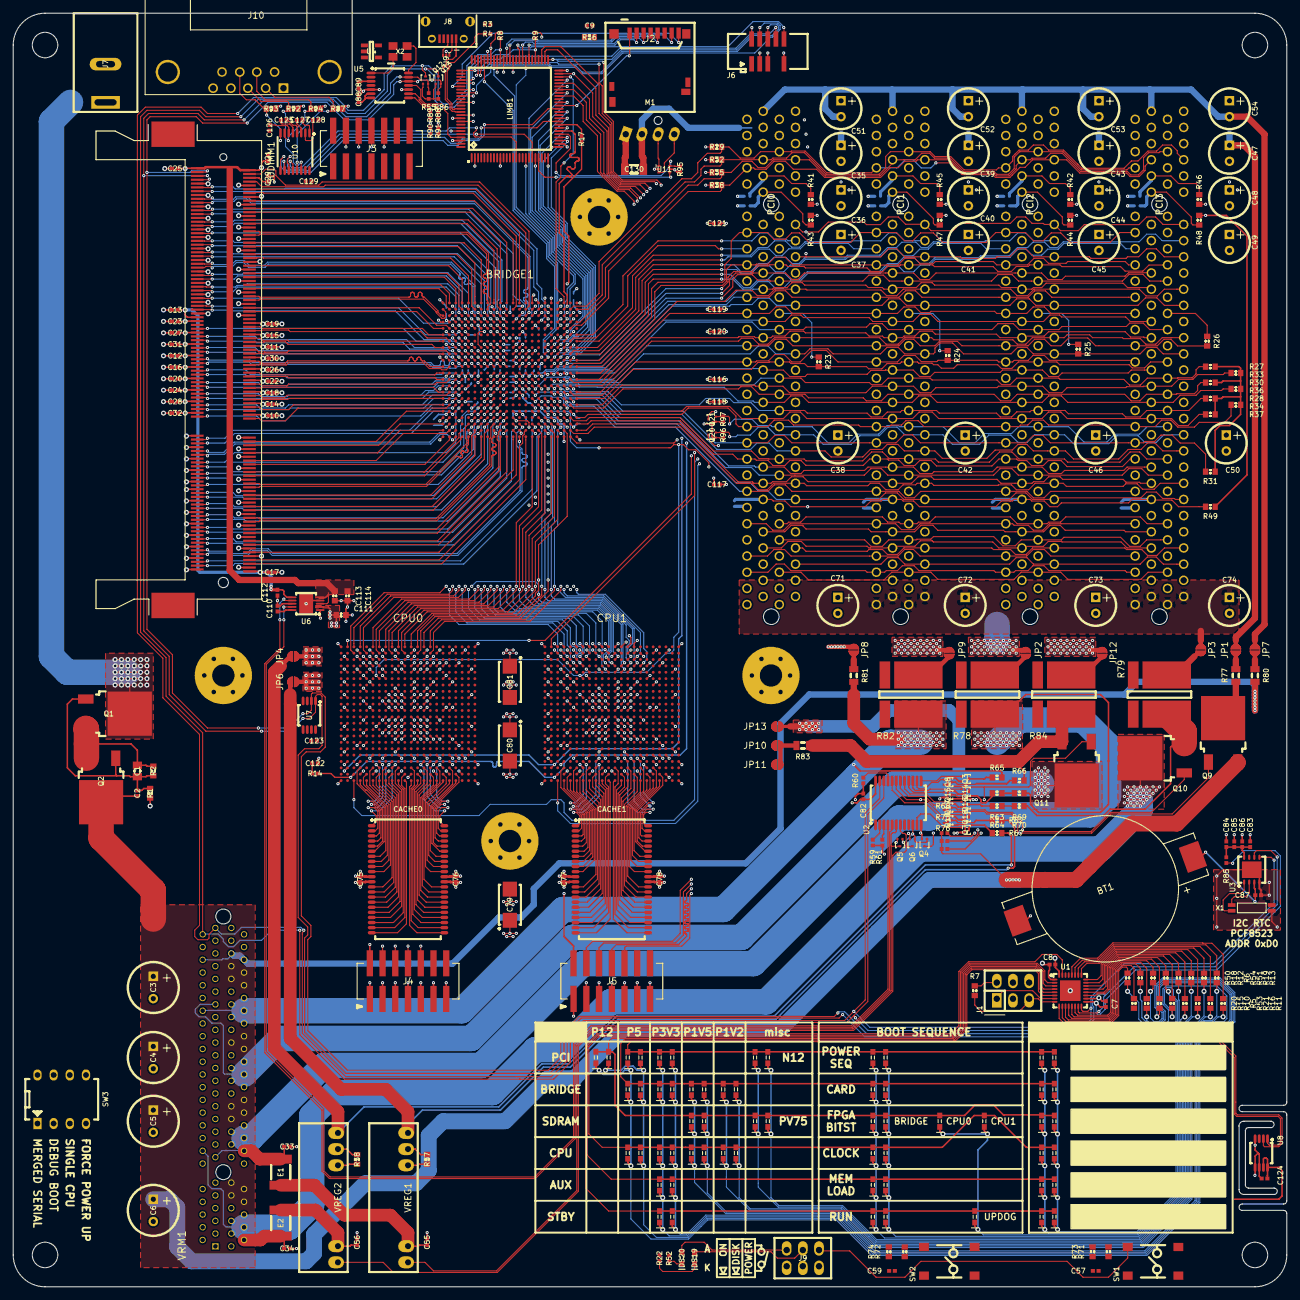
[picture p18: board c4puter.kicad_pcb from above]

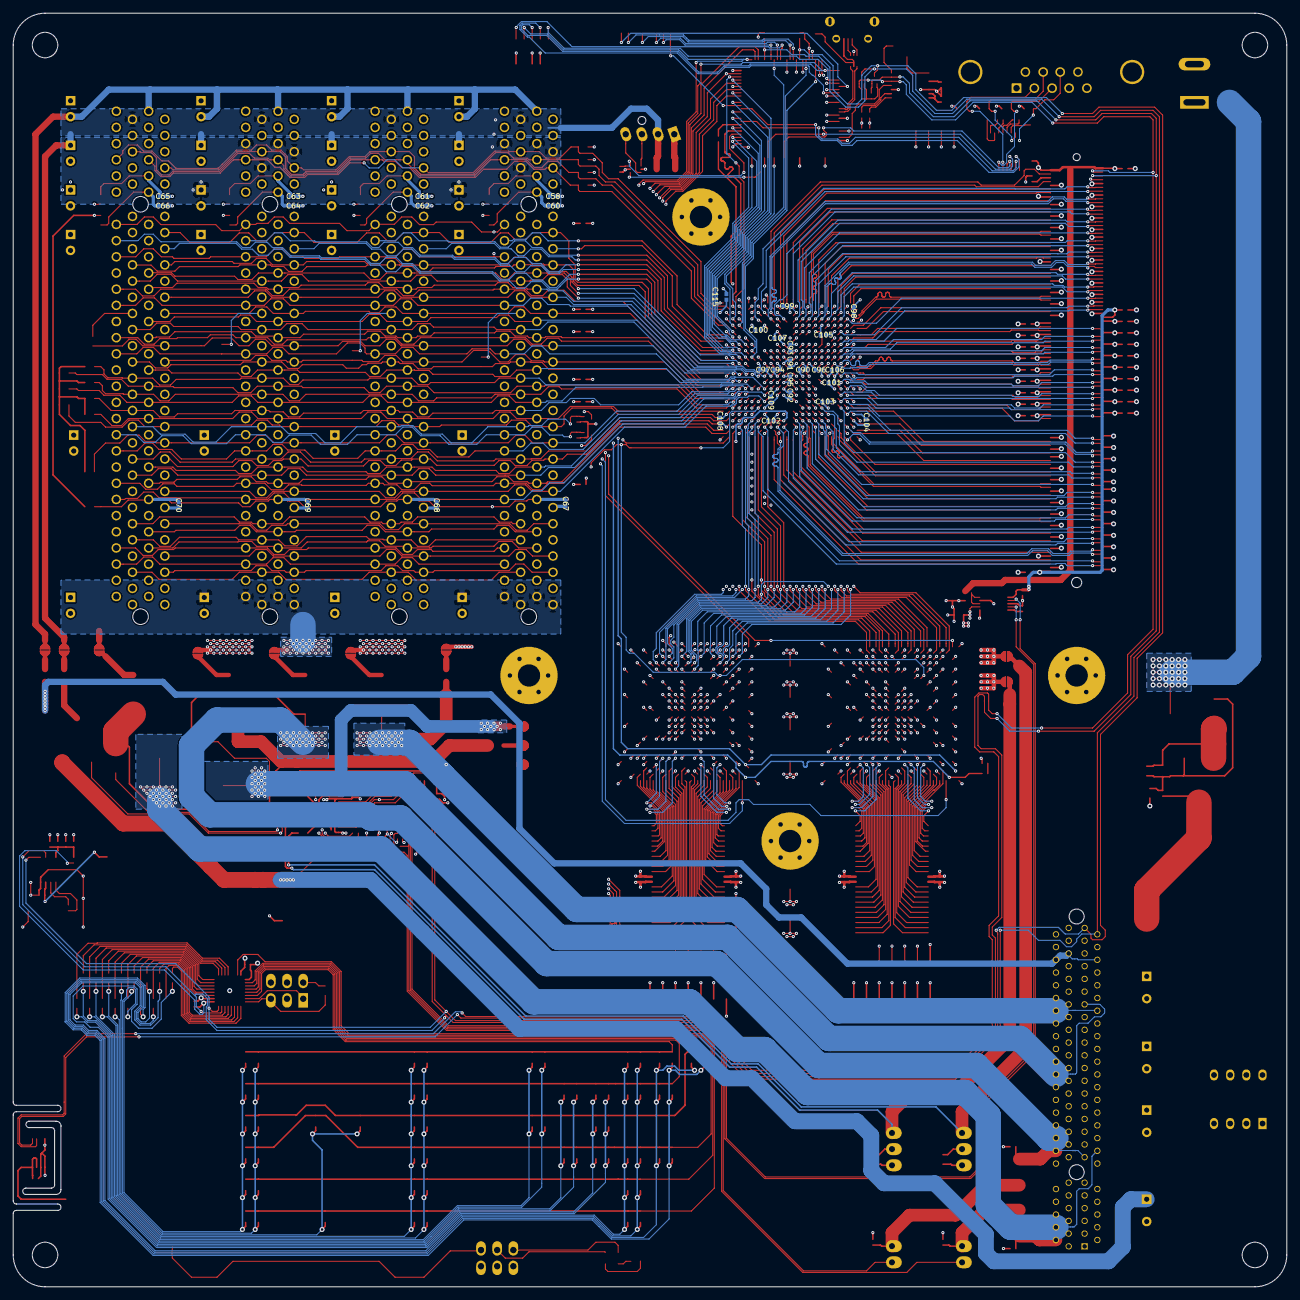
[picture p19: board c4puter.kicad_pcb from below]

Board: 6 copper layers, 200.0 x 200.0 mm, 374 parts (40 on the bottom side), 538 nets.

Parts:
BRIDGE1: XC6SLX25-FGG484; XILINX-FGG484
BT1: 3V; MPD-BU2032SM-HD-G
C1: 1u; CAPC2012X70
C2, C7, C8, C9, C10, C11, C12, C13, C14, C15, C16, C17, C18, C19, C20, C21, C22, C23, C24, C25, C26, C27, C28, C29, C30, C31, C32, C33, C34, C55, C56, C57, C59, C122, C125, C126, C127, C128, C129: 100n; CAPC1005X55
C3, C4, C5, C6: 390u; C-ALUM-8mm
C35, C39, C43, C47, C51, C52, C53, C54: 47u; C-ALUM-6.3mm
C36, C37, C38, C40, C41, C42, C44, C45, C46, C48, C49, C50, C71, C72, C73, C74: 220u; C-ALUM-6.3mm
C58, C60, C61, C62, C63, C64, C65, C66, C67, C68, C69, C70: 10n; CAPC1005X55
C75, C76, C77, C78, C82, C83, C84, C85, C86, C87, C88, C89, C90, C91, C92, C93, C94, C95, C96, C97, C98, C99, C100, C101, C102, C103, C104, C105, C106, C107, C108, C109, C110, C112, C115, C116, C117, C118, C119, C120, C121, C123, C124: 1u; CAPC1005X55
C79, C80, C81: 330u/6v3; CAPMP6032X280
C111, C113, C114: 10u; CAPC1608X55
C130: 4u7; CAPC3216X70
CACHE0, CACHE1: AS7C38098A; SOP80P1176X120-44
CPU0, CPU1: XC6SLX25-FGG484; XILINX-FGG484
DS1: PCI_P12(R); LED-0603
DS2: PCI_P12(G); LED-0603
DS3: PCI_P5(R); LED-0603
DS4: BRG_P5(R); LED-0603
DS5: CPU_P5(R); LED-0603
DS6: PCI_P5(G); LED-0603
DS7: BRG_P5(G); LED-0603
DS8: CPU_P5(G); LED-0603
DS9: PCI_P3V3(R); LED-0603
DS10: BRG_P3V3(R); LED-0603
DS11: CPU_P3V3(R); LED-0603
DS12: AUX_P3V3(R); LED-0603
DS13: SBY_P3V3(R); LED-0603
DS14: PCI_P3V3(G); LED-0603
DS15: BRG_P3V3(G); LED-0603
DS16: CPU_P3V3(G); LED-0603
DS17: AUX_P3V3(G); LED-0603
DS18: SBY_P3V3(G); LED-0603
DS19: ACT; LED-0603
DS20: POWER; LED-0603
DS23: BRG_P1V5(R); LED-0603
DS24: MEM_P1V5(R); LED-0603
DS25: CPU_P1V5(R); LED-0603
DS26: BRG_P1V5(G); LED-0603
DS27: MEM_P1V5(G); LED-0603
DS28: CPU_P1V5(G); LED-0603
DS29: BRG_P1V2(R); LED-0603
DS30: CPU_P1V2(R); LED-0603
DS31: BRG_P1V2(G); LED-0603
DS32: CPU_P1V2(G); LED-0603
DS33: PCI_N12(R); LED-0603
DS34: MEM_PV75(R); LED-0603
DS35: PCI_N12(G); LED-0603
DS36: MEM_PV75(G); LED-0603
DS37: POWER(R); LED-0603
DS38: CARD(R); LED-0603
DS39: BIT(R); LED-0603
DS40: CLK(R); LED-0603
DS41: MEM(R); LED-0603
DS42: RUN(R); LED-0603
DS43: POWER(G); LED-0603
DS44: CARD(G); LED-0603
DS45: BIT-BR(G); LED-0603
DS46: CLK(G); LED-0603
DS47: MEM(G); LED-0603
DS48: RUN(G); LED-0603
DS49: BIT-CPU0(G); LED-0603
DS50: BIT-CPU1(G); LED-0603
DS51: UPDOG(G); LED-0603
DS52, DS53, DS54, DS55, DS56, DS57: UNC(R); LED-0603
DS58, DS59, DS60, DS61, DS62, DS63: UNC(G); LED-0603
E1, E2: 100; CAPC4532X220
J1: PDI; CONN-100MIL-M-2x3
J2: MICROSD; AMPHENOL-114-00841-68
J3, J4, J5: JTAG; 98424-G52-14ALF
J6: DEBUG; CONN-100MIL-M-2x5-SHROUD
J7: 19V 3A; CONN-PJ-037A
J8: DEBUG; CONN-10118194-0001LF-FCI
J9: PANEL; CONN-100MIL-M-2x3
J10: RS232; DB9MC
JP1, JP2, JP3, JP4, JP6, JP7, JP8, JP9, JP10, JP11, JP12, JP13: JUMPER-SOLDER; JUMPER-SOLDER-SMD
LIMB1: ATSAM4S16CA-AU; QFP50P1600X1600X160-100
M1: FAN-4PIN; CONN-100MIL-M-1x4-SHROUD
MP1, MP2, MP3, MP4: SCREW; SCREW-4-SUPPORTED
PCI0, PCI1, PCI2, PCI3: CONN-5145154-1-PCI; 5145154-1
Q1, Q2: AOD4189; TO-252
Q3, Q4, Q5, Q6, Q7, Q8, Q12, Q13, Q14, Q15, Q16, Q17, Q18, Q19, Q20, Q21: FK3303010L; PANASONIC-SSSMini3-F2-B
Q9: AOD417; TO-252
Q10, Q11: AOD514; TO-252
R1, R56, R71, R72, R73, R74: 100k; RESC1608X50
R2: 330k; RESC1608X50
R3, R8, R9, R22, R52, R55, R86, R95, R96, R97: 5k1; RESC1005X40
R4, R68, R75, R76: 100k; RESC1005X40
R5, R10, R13, R15, R19, R20, R50, R51: 750; RESC1608X50
R6, R11, R12, R16, R18, R21, R53, R54: 300; RESC1608X50
R7: 51k; RESC1608X50
R14: 51; RESC1005X40
R17: 24; RESC1005X40
R23, R24, R25, R26: 160; RESC1608X50
R27, R28, R29, R30, R31, R32, R33, R34, R35, R36, R37, R38: 8k2; RESC1608X50
R41, R42, R43, R44, R45, R46, R47, R48, R49: 5k1; RESC1608X50
R57, R58: 22k6; RESC1608X50
R59, R60, R61: 0R; RESC1005X40
R62, R63, R64, R65, R66, R67, R69, R70: 120; RESC1608X50
R77, R81, R83: R01; RESC2012X50
R78, R79, R82, R84: R001; VISHAY-WSL3637-LARGE
R80: R20; RESC2012X50
R85: 1k; RESC1005X40
R87, R92, R93, R94: 22V; RESC1608X50
R88, R89, R90, R91: 91; RESC1005X40
SODIMM1: DDR3-SODIMM; Socket_SODIMM_DDR3_TE_2013289
SW1: POWER; CK-PTS645-SMD
SW2: SW; CK-PTS645-SMD
SW3: SW-DIP-4; DIP-8
U1: ATXMEGA8E5-MU; QFN50P500X500X100-33
U2: PCF8575; SOP65P775X200-24
U3: PCF8523TK; SON80P400X400X80-9
U4: TLV70218DBV; SOT-23-5
U5: CDCE913PW; SOP65P640X120-14
U6: RT9026GFP; SOP50P490X110-11
U7, U8: LM75BDP; SOP65P490X110-8
U9, U11: NUF2042XV6; SOT-563
U10: MAX3232PW; SOP65P640X140-16
VREG1, VREG2: OKX-T/5-W5N-C; MURATA-OKX-T5-W5
VRM1: C4-0-PSU; CONN-10018783-10202TLF-PCIEx8-FCI
W1, W2, W3, W4, W5, W6, W7: NET-TIE; NET-TIE-0.2mm
X1: 32768; CITIZEN-CM130
X2: 20MHz; ABRACON-ABM8G

Connections:
3V3_CARD: C9.2, J2.4, R56.1
+1V2: JP6.1, R62.1, VREG1.1
+1V5: JP4.1, R67.1, VREG2.1
+3VA: R65.1, R81.2, R82.1, VRM1.B33, VRM1.B34, VRM1.B35, VRM1.B36, VRM1.B37, VRM1.B38, VRM1.B39, W4.1
+3VB: JP13.1, Q11.3, VRM1.B23, VRM1.B24, VRM1.B25, VRM1.B26, VRM1.B27, VRM1.B28, VRM1.B29, W3.1
+5VA: C33.1, E1.1, R69.1, R78.1, VRM1.B12, VRM1.B13, VRM1.B14, VRM1.B15, VRM1.B16, VRM1.B17, VRM1.B18, W2.1
+5VB: C34.1, E2.1, Q10.3, VRM1.B1, VRM1.B2, VRM1.B3, VRM1.B4, VRM1.B5, VRM1.B6, VRM1.B7, W1.1
+12: C2.1, C3.1, C4.1, C5.1, C6.1, Q2.3, Q9.2, R68.1, R75.1, R76.1, VRM1.B8, VRM1.B9, VRM1.B10, VRM1.B11, VRM1.B19, VRM1.B20, VRM1.B21, VRM1.B22, VRM1.B30, VRM1.B31, VRM1.B32, VRM1.B40, VRM1.B41, VRM1.B42, VRM1.B43
-12: R80.2, VRM1.B44, VRM1.B45, W5.1
/12VIN: J7.1, Q1.3
/Blinkenlights/COL0: DS1.1, DS3.1, DS4.1, DS5.1, R10.1
/Blinkenlights/COL1: DS2.1, DS6.1, DS7.1, DS8.1, R12.1
/Blinkenlights/COL2: DS9.1, DS10.1, DS11.1, DS12.1, DS13.1, R15.1
/Blinkenlights/COL3: DS14.1, DS15.1, DS16.1, DS17.1, DS18.1, R18.1
/Blinkenlights/COL5: DS23.1, DS24.1, DS25.1, R50.1
/Blinkenlights/COL6: DS26.1, DS27.1, DS28.1, R11.1
/Blinkenlights/COL7: DS29.1, DS30.1, R13.1
/Blinkenlights/COL8: DS31.1, DS32.1, R16.1
/Blinkenlights/COL9: DS33.1, DS34.1, R19.1
/Blinkenlights/COL10: DS35.1, DS36.1, R21.1
/Blinkenlights/COL11: DS37.1, DS38.1, DS39.1, DS40.1, DS41.1, DS42.1, R51.1
/Blinkenlights/COL12: DS43.1, DS44.1, DS45.1, DS46.1, DS47.1, DS48.1, R53.1
/Blinkenlights/COL13: DS49.1, DS50.1, DS51.1, R54.1
/Blinkenlights/COL14: DS52.1, DS53.1, DS54.1, DS55.1, DS56.1, DS57.1, R5.2
/Blinkenlights/COL15: DS58.1, DS59.1, DS60.1, DS61.1, DS62.1, DS63.1, R6.2
/Blinkenlights/ROW0: DS3.2, DS6.2, DS9.2, DS14.2, DS33.2, DS35.2, DS37.2, DS43.2, DS52.2, DS58.2, U1.6
/Blinkenlights/ROW1: DS4.2, DS7.2, DS10.2, DS15.2, DS23.2, DS26.2, DS29.2, DS31.2, DS38.2, DS44.2, DS53.2, DS59.2, U1.5
/Blinkenlights/ROW2: DS1.2, DS2.2, DS24.2, DS27.2, DS34.2, DS36.2, DS39.2, DS45.2, DS49.2, DS54.2, DS60.2, U1.4
/Blinkenlights/ROW3: DS5.2, DS8.2, DS11.2, DS16.2, DS25.2, DS28.2, DS30.2, DS32.2, DS40.2, DS46.2, DS50.2, DS55.2, DS61.2, U1.3
/Blinkenlights/ROW4: DS12.2, DS17.2, DS41.2, DS47.2, DS56.2, DS62.2, U1.2
/Blinkenlights/ROW5: DS13.2, DS18.2, DS42.2, DS48.2, DS51.2, DS57.2, DS63.2, U1.31
/Blinkenlights/SCL: LIMB1.55, Q13.3, R9.2, U1.15, U2.22, U3.6, VRM1.A48
/Blinkenlights/SDA: LIMB1.66, Q12.3, R8.2, U1.16, U2.23, U3.5, VRM1.A49
/CPU0/ADDR#: BRIDGE1.R22, CPU0.H4, CPU1.H4
/CPU0/BUSACK#: BRIDGE1.U4, CPU0.J1
/CPU0/BUSCLK: BRIDGE1.K5, CPU0.K4, CPU1.K4, R89.1, R90.2
/CPU0/BUSINT#: BRIDGE1.T22, CPU0.H2
/CPU0/BUSREQ#: BRIDGE1.V22, CPU0.G4
/CPU0/CACHE_A0: CACHE0.5, CPU0.W20
/CPU0/CACHE_A1: CACHE0.4, CPU0.T20
/CPU0/CACHE_A2: CACHE0.3, CPU0.T19
/CPU0/CACHE_A3: CACHE0.2, CPU0.P19
/CPU0/CACHE_A4: CACHE0.1, CPU0.P20
/CPU0/CACHE_A5: CACHE0.44, CPU0.J19
/CPU0/CACHE_A6: CACHE0.43, CPU0.H19
/CPU0/CACHE_A7: CACHE0.42, CPU0.G19
/CPU0/CACHE_A8: CACHE0.28, CPU0.J20
/CPU0/CACHE_A9: CACHE0.27, CPU0.J22
/CPU0/CACHE_A10: CACHE0.26, CPU0.K21
/CPU0/CACHE_A11: CACHE0.25, CPU0.K22
/CPU0/CACHE_A12: CACHE0.24, CPU0.L20
/CPU0/CACHE_A13: CACHE0.23, CPU0.L22
/CPU0/CACHE_A14: CACHE0.22, CPU0.M22
/CPU0/CACHE_A15: CACHE0.21, CPU0.M21
/CPU0/CACHE_A16: CACHE0.20, CPU0.N22
/CPU0/CACHE_A17: CACHE0.19, CPU0.N20
/CPU0/CACHE_A18: CACHE0.18, CPU0.P22
/CPU0/CACHE_DQ0: CACHE0.7, CPU0.V21
/CPU0/CACHE_DQ1: CACHE0.8, CPU0.V22
/CPU0/CACHE_DQ2: CACHE0.9, CPU0.U20
/CPU0/CACHE_DQ3: CACHE0.10, CPU0.U22
/CPU0/CACHE_DQ4: CACHE0.13, CPU0.T21
/CPU0/CACHE_DQ5: CACHE0.14, CPU0.T22
/CPU0/CACHE_DQ6: CACHE0.15, CPU0.R20
/CPU0/CACHE_DQ7: CACHE0.16, CPU0.R22
/CPU0/CACHE_DQ8: CACHE0.29, CPU0.H22
/CPU0/CACHE_DQ9: CACHE0.30, CPU0.H21
/CPU0/CACHE_DQ10: CACHE0.31, CPU0.G22
/CPU0/CACHE_DQ11: CACHE0.32, CPU0.G20
/CPU0/CACHE_DQ12: CACHE0.35, CPU0.F22
/CPU0/CACHE_DQ13: CACHE0.36, CPU0.F21
/CPU0/CACHE_DQ14: CACHE0.37, CPU0.E22
/CPU0/CACHE_DQ15: CACHE0.38, CPU0.E20
/CPU0/CACHE_~CE: CACHE0.6, CPU0.W22
/CPU0/CACHE_~LB: CACHE0.39, CPU0.D22
/CPU0/CACHE_~OE: CACHE0.41, CPU0.F20
/CPU0/CACHE_~UB: CACHE0.40, CPU0.D21
/CPU0/CACHE_~WE: CACHE0.17, CPU0.P21
/CPU0/CCLK: BRIDGE1.Y21, CPU0.Y21, CPU1.Y21, LIMB1.31, R14.1
/CPU0/DIN: BRIDGE1.AA20, CPU0.AA20, CPU1.AA20, R17.2
/CPU0/DONE: CPU0.Y22, LIMB1.49
/CPU0/INIT_B: BRIDGE1.T6, CPU0.T6, CPU1.T6, LIMB1.53
/CPU0/PROGRAM_B: CPU0.AA1, LIMB1.46
/CPU1/BUSACK#: BRIDGE1.V21, CPU1.J1
/CPU1/BUSINT#: BRIDGE1.W20, CPU1.H2
/CPU1/BUSREQ#: BRIDGE1.W22, CPU1.G4
/CPU1/CACHE_A0: CACHE1.5, CPU1.W20
/CPU1/CACHE_A1: CACHE1.4, CPU1.T20
/CPU1/CACHE_A2: CACHE1.3, CPU1.T19
/CPU1/CACHE_A3: CACHE1.2, CPU1.P19
/CPU1/CACHE_A4: CACHE1.1, CPU1.P20
/CPU1/CACHE_A5: CACHE1.44, CPU1.J19
/CPU1/CACHE_A6: CACHE1.43, CPU1.H19
/CPU1/CACHE_A7: CACHE1.42, CPU1.G19
/CPU1/CACHE_A8: CACHE1.28, CPU1.J20
/CPU1/CACHE_A9: CACHE1.27, CPU1.J22
/CPU1/CACHE_A10: CACHE1.26, CPU1.K21
/CPU1/CACHE_A11: CACHE1.25, CPU1.K22
/CPU1/CACHE_A12: CACHE1.24, CPU1.L20
/CPU1/CACHE_A13: CACHE1.23, CPU1.L22
/CPU1/CACHE_A14: CACHE1.22, CPU1.M22
/CPU1/CACHE_A15: CACHE1.21, CPU1.M21
/CPU1/CACHE_A16: CACHE1.20, CPU1.N22
/CPU1/CACHE_A17: CACHE1.19, CPU1.N20
/CPU1/CACHE_A18: CACHE1.18, CPU1.P22
/CPU1/CACHE_DQ0: CACHE1.7, CPU1.V21
/CPU1/CACHE_DQ1: CACHE1.8, CPU1.V22
/CPU1/CACHE_DQ2: CACHE1.9, CPU1.U20
/CPU1/CACHE_DQ3: CACHE1.10, CPU1.U22
/CPU1/CACHE_DQ4: CACHE1.13, CPU1.T21
/CPU1/CACHE_DQ5: CACHE1.14, CPU1.T22
/CPU1/CACHE_DQ6: CACHE1.15, CPU1.R20
/CPU1/CACHE_DQ7: CACHE1.16, CPU1.R22
/CPU1/CACHE_DQ8: CACHE1.29, CPU1.H22
/CPU1/CACHE_DQ9: CACHE1.30, CPU1.H21
/CPU1/CACHE_DQ10: CACHE1.31, CPU1.G22
/CPU1/CACHE_DQ11: CACHE1.32, CPU1.G20
/CPU1/CACHE_DQ12: CACHE1.35, CPU1.F22
/CPU1/CACHE_DQ13: CACHE1.36, CPU1.F21
/CPU1/CACHE_DQ14: CACHE1.37, CPU1.E22
/CPU1/CACHE_DQ15: CACHE1.38, CPU1.E20
/CPU1/CACHE_~CE: CACHE1.6, CPU1.W22
/CPU1/CACHE_~LB: CACHE1.39, CPU1.D22
/CPU1/CACHE_~OE: CACHE1.41, CPU1.F20
/CPU1/CACHE_~UB: CACHE1.40, CPU1.D21
/CPU1/CACHE_~WE: CACHE1.17, CPU1.P21
/CPU1/DONE: CPU1.Y22, LIMB1.52
/CPU1/PROGRAM_B: CPU1.AA1, LIMB1.44
/EC/A15: BRIDGE1.Y19, LIMB1.18
/EC/BTN_AUX: C59.1, R74.1
/EC/BTN_PWR: C57.1, R73.1
/EC/CARD_DET#: J2.10, R56.2
/EC/CLK: LIMB1.97, U5.11
/EC/CTS1: LIMB1.38, U10.9
/EC/D0: BRIDGE1.V13, LIMB1.25
/EC/D1: BRIDGE1.Y18, LIMB1.47
/EC/D2: BRIDGE1.Y17, LIMB1.43
/EC/D3: BRIDGE1.Y16, LIMB1.40
/EC/D4: BRIDGE1.W15, LIMB1.37
/EC/D5: BRIDGE1.Y15, LIMB1.35
/EC/D6: BRIDGE1.W14, LIMB1.32
/EC/D7: BRIDGE1.Y14, LIMB1.29
/EC/FANPWM: LIMB1.22, U11.4
/EC/FANTACH: LIMB1.30, R95.2, U11.6
/EC/LED_ACT: DS19.2, J9.4
/EC/LED_PWR: DS20.2, J9.2
/EC/MCCDA: J2.3, LIMB1.59
/EC/MCCK: J2.5, LIMB1.63
/EC/MCDA0: J2.7, LIMB1.64
/EC/MCDA1: J2.8, LIMB1.81
/EC/MCDA2: J2.1, LIMB1.39
/EC/MCDA3: J2.2, LIMB1.57
/EC/MOSI: LIMB1.33, R17.1
/EC/OUT_USB1_D+: J8.3, U9.3
/EC/OUT_USB1_D-: J8.2, U9.1
/EC/PCI_SCL: PCI0.A40, PCI1.A40, PCI2.A40, PCI3.A40, Q21.2, R97.2
/EC/PCI_SDA: PCI0.A41, PCI1.A41, PCI2.A41, PCI3.A41, Q20.2, R96.2
/EC/RSCTS: J10.8, R93.1, U10.8
/EC/RSRD: J10.2, R87.1, U10.13
/EC/RSRTS: J10.7, R94.1, U10.7
/EC/RSTD: J10.3, R92.1, U10.14
/EC/RTS1: LIMB1.34, U10.10
/EC/RXD1: LIMB1.15, U10.12
/EC/SCK1: LIMB1.76, Q21.3, W7.1
/EC/SDA1: LIMB1.51, Q20.3, W6.1
/EC/TCK: J6.4, LIMB1.83
/EC/TDI: J6.8, W6.2
/EC/TDO: J6.6, W7.2
/EC/TMS: J6.2, LIMB1.79
/EC/TXD1: LIMB1.20, U10.11
/EC/USB_D+: LIMB1.89, U9.4
/EC/USB_D-: LIMB1.88, U9.6
/EC/XFANPWM: M1.4, U11.3
/EC/XFANTACH: M1.3, U11.1
/EC/~PCIPME: LIMB1.90, PCI0.A19, PCI1.A19, PCI2.A19, PCI3.A19
/EC/~PCIRST: LIMB1.86, PCI0.A15, PCI1.A15, PCI2.A15, PCI3.A15
/EC/~PRSNT1_0: C58.1, LIMB1.84, PCI0.B9, R41.2
/EC/~PRSNT1_1: C61.1, LIMB1.73, PCI1.B9, R45.2
/EC/~PRSNT1_2: C63.1, LIMB1.67, PCI2.B9, R42.2
/EC/~PRSNT1_3: C65.1, LIMB1.62, PCI3.B9, R46.2
/EC/~PRSNT2_0: C60.1, LIMB1.82, PCI0.B11, R43.2
/EC/~PRSNT2_1: C62.1, LIMB1.80, PCI1.B11, R47.2
/EC/~PRSNT2_2: C64.1, LIMB1.72, PCI2.B11, R44.2
/EC/~PRSNT2_3: C66.1, LIMB1.65, PCI3.B11, R48.2
/EC/~RST: J6.10, LIMB1.60
/Misc/CLK_SDRAM: BRIDGE1.C12, R88.1, R91.2
/Multibridge/A0: BRIDGE1.D11, SODIMM1.98
/Multibridge/A1: BRIDGE1.A11, SODIMM1.97
/Multibridge/A2: BRIDGE1.C11, SODIMM1.96
/Multibridge/A3: BRIDGE1.A10, SODIMM1.95
/Multibridge/A4: BRIDGE1.D10, SODIMM1.92
/Multibridge/A5: BRIDGE1.B10, SODIMM1.91
/Multibridge/A6: BRIDGE1.C10, SODIMM1.90
/Multibridge/A7: BRIDGE1.C9, SODIMM1.86
/Multibridge/A8: BRIDGE1.A8, SODIMM1.89
/Multibridge/A9: BRIDGE1.B8, SODIMM1.85
/Multibridge/A10: BRIDGE1.A14, SODIMM1.107
/Multibridge/A11: BRIDGE1.D8, SODIMM1.84
/Multibridge/A12: BRIDGE1.A7, SODIMM1.83
/Multibridge/A13: BRIDGE1.B16, SODIMM1.119
/Multibridge/A14: BRIDGE1.C8, SODIMM1.80
/Multibridge/A15: BRIDGE1.D7, SODIMM1.78
/Multibridge/BA0: BRIDGE1.B14, SODIMM1.109
/Multibridge/BA1: BRIDGE1.C13, SODIMM1.108
/Multibridge/BA2: BRIDGE1.A6, SODIMM1.79
/Multibridge/CK0_N: BRIDGE1.A12, SODIMM1.103
/Multibridge/CK0_P: BRIDGE1.B12, SODIMM1.101
/Multibridge/CK1_N: BRIDGE1.D12, SODIMM1.104
/Multibridge/CK1_P: BRIDGE1.E12, SODIMM1.102
/Multibridge/CKE0: BRIDGE1.B6, SODIMM1.73
/Multibridge/CKE1: BRIDGE1.C7, SODIMM1.74
/Multibridge/CPU_D0: BRIDGE1.C17, CPU0.Y2, CPU1.Y2
/Multibridge/CPU_D1: BRIDGE1.E14, CPU0.Y1, CPU1.Y1
/Multibridge/CPU_D2: BRIDGE1.D9, CPU0.W3, CPU1.W3
/Multibridge/CPU_D3: BRIDGE1.G13, CPU0.W1, CPU1.W1
/Multibridge/CPU_D4: BRIDGE1.F12, CPU0.V3, CPU1.V3
/Multibridge/CPU_D5: BRIDGE1.H5, CPU0.V2, CPU1.V2
/Multibridge/CPU_D6: BRIDGE1.T21, CPU0.N3, CPU1.N3
/Multibridge/CPU_D7: BRIDGE1.H13, CPU0.U4, CPU1.U4
/Multibridge/CPU_D8: BRIDGE1.J6, CPU0.U3, CPU1.U3
/Multibridge/CPU_D9: BRIDGE1.J7, CPU0.U1, CPU1.U1
/Multibridge/CPU_D10: BRIDGE1.K6, CPU0.T4, CPU1.T4
/Multibridge/CPU_D11: BRIDGE1.N20, CPU0.T3, CPU1.T3
/Multibridge/CPU_D12: BRIDGE1.M5, CPU0.T2, CPU1.T2
/Multibridge/CPU_D13: BRIDGE1.U20, CPU0.T1, CPU1.T1
/Multibridge/CPU_D14: BRIDGE1.T20, CPU0.R3, CPU1.R3
/Multibridge/CPU_D15: BRIDGE1.F18, CPU0.R1, CPU1.R1
/Multibridge/CPU_D16: BRIDGE1.H18, CPU0.P2, CPU1.P2
/Multibridge/CPU_D17: BRIDGE1.K18, CPU0.P1, CPU1.P1
/Multibridge/CPU_D18: BRIDGE1.R1, CPU0.N1, CPU1.N1
/Multibridge/CPU_D19: BRIDGE1.G20, CPU0.M5, CPU1.M5
/Multibridge/CPU_D20: BRIDGE1.J17, CPU0.M4, CPU1.M4
/Multibridge/CPU_D21: BRIDGE1.T2, CPU0.M2, CPU1.M2
/Multibridge/CPU_D22: BRIDGE1.V1, CPU0.M1, CPU1.M1
/Multibridge/CPU_D23: BRIDGE1.V2, CPU0.K5, CPU1.K5
/Multibridge/CPU_D24: BRIDGE1.U1, CPU0.L3, CPU1.L3
/Multibridge/CPU_D25: BRIDGE1.W1, CPU0.L1, CPU1.L1
/Multibridge/CPU_D26: BRIDGE1.U3, CPU0.J4, CPU1.J4
/Multibridge/CPU_D27: BRIDGE1.V3, CPU0.J3, CPU1.J3
/Multibridge/CPU_D28: BRIDGE1.T4, CPU0.K2, CPU1.K2
/Multibridge/CPU_D29: BRIDGE1.Y2, CPU0.K1, CPU1.K1
/Multibridge/CPU_D30: BRIDGE1.W3, CPU0.H1, CPU1.H1
/Multibridge/CPU_D31: BRIDGE1.K17, CPU0.M3, CPU1.M3
/Multibridge/CPU_WAIT#: BRIDGE1.T1, CPU0.L4, CPU1.L4
/Multibridge/CPU_WR#: BRIDGE1.U22, CPU0.H3, CPU1.H3
/Multibridge/DM0: BRIDGE1.M2, SODIMM1.11
/Multibridge/DM1: BRIDGE1.K3, SODIMM1.28
/Multibridge/DM2: BRIDGE1.G4, SODIMM1.46
/Multibridge/DM3: BRIDGE1.A2, SODIMM1.63
/Multibridge/DM4: BRIDGE1.C19, SODIMM1.136
/Multibridge/DM5: BRIDGE1.D22, SODIMM1.153
/Multibridge/DM6: BRIDGE1.K19, SODIMM1.170
/Multibridge/DM7: BRIDGE1.M22, SODIMM1.187
/Multibridge/DONE: BRIDGE1.Y22, LIMB1.48
/Multibridge/DQ0: BRIDGE1.P1, SODIMM1.5
/Multibridge/DQ1: BRIDGE1.P2, SODIMM1.7
/Multibridge/DQ2: BRIDGE1.M1, SODIMM1.15
/Multibridge/DQ3: BRIDGE1.L1, SODIMM1.17
/Multibridge/DQ4: BRIDGE1.T3, SODIMM1.4
/Multibridge/DQ5: BRIDGE1.R3, SODIMM1.6
/Multibridge/DQ7: BRIDGE1.M3, SODIMM1.18
/Multibridge/DQ8: BRIDGE1.K1, SODIMM1.21
/Multibridge/DQ9: BRIDGE1.K2, SODIMM1.23
/Multibridge/DQ10: BRIDGE1.H2, SODIMM1.33
/Multibridge/DQ11: BRIDGE1.G1, SODIMM1.35
/Multibridge/DQ12: BRIDGE1.L3, SODIMM1.22
/Multibridge/DQ13: BRIDGE1.L4, SODIMM1.24
/Multibridge/DQ14: BRIDGE1.J4, SODIMM1.34
/Multibridge/DQ15: BRIDGE1.H3, SODIMM1.36
/Multibridge/DQ16: BRIDGE1.F1, SODIMM1.39
/Multibridge/DQ17: BRIDGE1.F2, SODIMM1.41
/Multibridge/DQ18: BRIDGE1.D1, SODIMM1.51
/Multibridge/DQ19: BRIDGE1.D2, SODIMM1.53
/Multibridge/DQ20: BRIDGE1.H4, SODIMM1.40
/Multibridge/DQ21: BRIDGE1.G3, SODIMM1.42
/Multibridge/DQ22: BRIDGE1.F3, SODIMM1.50
/Multibridge/DQ23: BRIDGE1.F5, SODIMM1.52
/Multibridge/DQ24: BRIDGE1.B1, SODIMM1.57
/Multibridge/DQ25: BRIDGE1.B2, SODIMM1.59
/Multibridge/DQ26: BRIDGE1.A3, SODIMM1.67
/Multibridge/DQ27: BRIDGE1.A5, SODIMM1.69
/Multibridge/DQ28: BRIDGE1.G6, SODIMM1.56
/Multibridge/DQ29: BRIDGE1.D6, SODIMM1.58
/Multibridge/DQ30: BRIDGE1.C5, SODIMM1.68
/Multibridge/DQ31: BRIDGE1.C6, SODIMM1.70
/Multibridge/DQ32: BRIDGE1.A18, SODIMM1.129
/Multibridge/DQ33: BRIDGE1.B18, SODIMM1.131
/Multibridge/DQ34: BRIDGE1.B21, SODIMM1.141
/Multibridge/DQ35: BRIDGE1.B22, SODIMM1.143
/Multibridge/DQ36: BRIDGE1.D15, SODIMM1.130
/Multibridge/DQ37: BRIDGE1.D17, SODIMM1.132
/Multibridge/DQ38: BRIDGE1.D19, SODIMM1.140
/Multibridge/DQ39: BRIDGE1.D20, SODIMM1.142
/Multibridge/DQ40: BRIDGE1.C22, SODIMM1.147
/Multibridge/DQ41: BRIDGE1.D21, SODIMM1.149
/Multibridge/DQ42: BRIDGE1.E22, SODIMM1.157
/Multibridge/DQ43: BRIDGE1.F21, SODIMM1.159
/Multibridge/DQ44: BRIDGE1.E20, SODIMM1.146
/Multibridge/DQ45: BRIDGE1.F19, SODIMM1.148
/Multibridge/DQ46: BRIDGE1.H19, SODIMM1.158
/Multibridge/DQ47: BRIDGE1.H20, SODIMM1.160
/Multibridge/DQ48: BRIDGE1.F22, SODIMM1.163
/Multibridge/DQ49: BRIDGE1.G22, SODIMM1.165
/Multibridge/DQ50: BRIDGE1.J22, SODIMM1.175
/Multibridge/DQ51: BRIDGE1.K21, SODIMM1.177
/Multibridge/DQ52: BRIDGE1.J19, SODIMM1.164
/Multibridge/DQ53: BRIDGE1.J20, SODIMM1.166
/Multibridge/DQ54: BRIDGE1.K20, SODIMM1.174
/Multibridge/DQ55: BRIDGE1.L19, SODIMM1.176
/Multibridge/DQ56: BRIDGE1.K22, SODIMM1.181
/Multibridge/DQ57: BRIDGE1.L22, SODIMM1.183
/Multibridge/DQ58: BRIDGE1.M21, SODIMM1.191
/Multibridge/DQ59: BRIDGE1.N22, SODIMM1.193
/Multibridge/DQ60: BRIDGE1.L20, SODIMM1.180
/Multibridge/DQ61: BRIDGE1.M19, SODIMM1.182
/Multibridge/DQ62: BRIDGE1.R20, SODIMM1.192
/Multibridge/DQ63: BRIDGE1.T19, SODIMM1.194
/Multibridge/DQS0_N: BRIDGE1.N1, SODIMM1.10
/Multibridge/DQS0_P: BRIDGE1.N3, SODIMM1.12
/Multibridge/DQS1_N: BRIDGE1.J1, SODIMM1.27
/Multibridge/DQS1_P: BRIDGE1.J3, SODIMM1.29
/Multibridge/DQS2_N: BRIDGE1.E1, SODIMM1.45
/Multibridge/DQS2_P: BRIDGE1.E3, SODIMM1.47
/Multibridge/DQS3_N: BRIDGE1.C1, SODIMM1.62
/Multibridge/DQS3_P: BRIDGE1.C3, SODIMM1.64
/Multibridge/DQS4_N: BRIDGE1.A21, SODIMM1.135
/Multibridge/DQS4_P: BRIDGE1.A20, SODIMM1.137
/Multibridge/DQS5_N: BRIDGE1.F20, SODIMM1.152
/Multibridge/DQS5_P: BRIDGE1.G19, SODIMM1.154
/Multibridge/DQS6_N: BRIDGE1.H22, SODIMM1.169
/Multibridge/DQS6_P: BRIDGE1.H21, SODIMM1.171
/Multibridge/DQS7_N: BRIDGE1.P20, SODIMM1.186
/Multibridge/DQS7_P: BRIDGE1.P19, SODIMM1.188
/Multibridge/LIMBNCS: BRIDGE1.U13, LIMB1.71
/Multibridge/LIMBNRD: BRIDGE1.U14, LIMB1.68
/Multibridge/LIMBNWAIT: BRIDGE1.V15, LIMB1.21
/Multibridge/LIMBNWE: BRIDGE1.W18, LIMB1.58
/Multibridge/LIMBREQ: BRIDGE1.W13, LIMB1.28
/Multibridge/ODT0: BRIDGE1.D14, SODIMM1.116
/Multibridge/ODT1: BRIDGE1.C15, SODIMM1.120
/Multibridge/PROGRAM_B: BRIDGE1.AA1, LIMB1.42
/Multibridge/SA0: BRIDGE1.P22, SODIMM1.197
/Multibridge/SA1: BRIDGE1.P21, SODIMM1.201
/Multibridge/SCL: Q13.2, R86.2, SODIMM1.202, U5.12, U7.2, U8.2
/Multibridge/SDA: Q12.2, R55.2, SODIMM1.200, U5.13, U7.1, U8.1
/Multibridge/SDRAM_~RST: BRIDGE1.K4, SODIMM1.30
/Multibridge/~CAS: BRIDGE1.A16, SODIMM1.115
/Multibridge/~PCI_PERR: BRIDGE1.AB4, PCI0.B40, PCI1.B40, PCI2.B40, PCI3.B40, R34.2
/Multibridge/~PCI_REQ0: BRIDGE1.AA16, PCI0.B18
/Multibridge/~PCI_REQ1: BRIDGE1.AB15, PCI1.B18
/Multibridge/~PCI_REQ2: BRIDGE1.AB14, PCI2.B18
/Multibridge/~PCI_REQ3: BRIDGE1.AA12, PCI3.B18
/Multibridge/~PCI_SERR: BRIDGE1.W9, PCI0.B42, PCI1.B42, PCI2.B42, PCI3.B42, R31.2
/Multibridge/~PCI_STOP: BRIDGE1.Y9, PCI0.A38, PCI1.A38, PCI2.A38, PCI3.A38, R28.2
/Multibridge/~PCI_TRDY: BRIDGE1.AA6, PCI0.A36, PCI1.A36, PCI2.A36, PCI3.A36, R30.2
/Multibridge/~RAS: BRIDGE1.D13, SODIMM1.110
/Multibridge/~S0: BRIDGE1.C14, SODIMM1.114
/Multibridge/~S1: BRIDGE1.A17, SODIMM1.121
/Multibridge/~WE: BRIDGE1.A15, SODIMM1.113
/PCI/AD0: BRIDGE1.Y3, PCI0.A58, PCI1.A58, PCI2.A58, PCI3.A58
/PCI/AD1: BRIDGE1.Y4, PCI0.B58, PCI2.B58, PCI3.B58
/PCI/AD2: BRIDGE1.W4, PCI0.A57, PCI1.A57, PCI2.A57, PCI3.A57
/PCI/AD3: BRIDGE1.Y5, PCI0.B56, PCI1.B56, PCI2.B56, PCI3.B56
/PCI/AD4: BRIDGE1.V5, PCI0.A55, PCI1.A55, PCI2.A55, PCI3.A55
/PCI/AD5: BRIDGE1.Y6, PCI0.B55, PCI1.B55, PCI2.B55, PCI3.B55
/PCI/AD6: BRIDGE1.W6, PCI0.A54, PCI1.A54, PCI2.A54, PCI3.A54
/PCI/AD7: BRIDGE1.V7, PCI0.B53, PCI1.B53, PCI2.B53, PCI3.B53
/PCI/AD8: BRIDGE1.U6, PCI0.B52, PCI1.B52, PCI2.B52, PCI3.B52
/PCI/AD9: BRIDGE1.Y7, PCI0.A49, PCI1.A49, PCI2.A49, PCI3.A49
/PCI/AD10: BRIDGE1.R7, PCI0.B48, PCI1.B48, PCI2.B48, PCI3.B48
/PCI/AD11: BRIDGE1.AA2, PCI0.A47, PCI1.A47, PCI2.A47, PCI3.A47
/PCI/AD12: BRIDGE1.AB2, PCI0.B47, PCI1.B47, PCI2.B47, PCI3.B47
/PCI/AD13: BRIDGE1.W8, PCI0.A46, PCI1.A46, PCI2.A46, PCI3.A46
/PCI/AD14: BRIDGE1.R8, PCI0.B45, PCI1.B45, PCI2.B45, PCI3.B45
/PCI/AD15: BRIDGE1.AA4, PCI0.A44, PCI1.A44, PCI2.A44, PCI3.A44
/PCI/AD16: BRIDGE1.AB7, PCI0.A32, PCI1.A32, PCI2.A32, PCI3.A32, R23.2
/PCI/AD17: BRIDGE1.AA8, PCI0.B32, PCI1.B32, PCI2.B32, PCI3.B32, R24.2
/PCI/AD18: BRIDGE1.W10, PCI0.A31, PCI1.A31, PCI2.A31, PCI3.A31, R25.2
/PCI/AD19: BRIDGE1.R9, PCI0.B30, PCI1.B30, PCI2.B30, PCI3.B30, R26.2
/PCI/AD20: BRIDGE1.AB8, PCI0.A29, PCI1.A29, PCI2.A29, PCI3.A29
/PCI/AD21: BRIDGE1.AB9, PCI0.B29, PCI1.B29, PCI2.B29, PCI3.B29
/PCI/AD22: BRIDGE1.Y11, PCI0.A28, PCI1.A28, PCI2.A28, PCI3.A28
/PCI/AD23: BRIDGE1.W11, PCI0.B27, PCI1.B27, PCI2.B27, PCI3.B27
/PCI/AD24: BRIDGE1.V11, PCI0.A25, PCI1.A25, PCI2.A25, PCI3.A25
/PCI/AD25: BRIDGE1.T11, PCI0.B24, PCI1.B24, PCI2.B24, PCI3.B24
/PCI/AD26: BRIDGE1.AB10, PCI0.A23, PCI1.A23, PCI2.A23, PCI3.A23
/PCI/AD27: BRIDGE1.R11, PCI0.B23, PCI1.B23, PCI2.B23, PCI3.B23
/PCI/AD28: BRIDGE1.Y12, PCI0.A22, PCI1.A22, PCI2.A22, PCI3.A22
/PCI/AD29: BRIDGE1.W12, PCI0.B21, PCI1.B21, PCI2.B21, PCI3.B21
/PCI/AD30: BRIDGE1.Y13, PCI0.A20, PCI1.A20, PCI2.A20, PCI3.A20
/PCI/AD31: BRIDGE1.AB11, PCI0.B20, PCI1.B20, PCI2.B20, PCI3.B20
/PCI/CLK: BRIDGE1.AB12, PCI0.B16, PCI1.B16, PCI2.B16, PCI3.B16
/PCI/IDSEL0: PCI0.A26, R23.1
/PCI/IDSEL1: PCI1.A26, R24.1
/PCI/IDSEL2: PCI2.A26, R25.1
/PCI/IDSEL3: PCI3.A26, R26.1
/PCI/M66EN: C67.1, C68.1, C69.1, C70.1, LIMB1.92, PCI0.B49, PCI1.B49, PCI2.B49, PCI3.B49, R49.1
/PCI/PAR: BRIDGE1.Y8, PCI0.A43, PCI1.A43, PCI2.A43, PCI3.A43
/PCI/PCI_TCK: PCI0.B2, PCI1.B2, PCI2.B2, PCI3.B2
/PCI/PCI_TDI: PCI0.A4, PCI1.A4, PCI2.A4, PCI3.A4
/PCI/PCI_TDO: PCI0.B4, PCI1.B4, PCI2.B4, PCI3.B4
/PCI/PCI_TMS: PCI0.A3, PCI1.A3, PCI2.A3, PCI3.A3
/PCI/PCI_TRST#: PCI0.A1, PCI1.A1, PCI2.A1, PCI3.A1
/PCI/~CBE0: BRIDGE1.T7, PCI0.A52, PCI1.A52, PCI2.A52, PCI3.A52
/PCI/~CBE1: BRIDGE1.AB3, PCI0.B44, PCI1.B44, PCI2.B44, PCI3.B44
/PCI/~CBE2: BRIDGE1.Y10, PCI0.B33, PCI1.B33, PCI2.B33, PCI3.B33
/PCI/~CBE3: BRIDGE1.AA10, PCI0.B26, PCI1.B26, PCI2.B26, PCI3.B26
/PCI/~DEVSEL: BRIDGE1.V9, PCI0.B37, PCI1.B37, PCI2.B37, PCI3.B37, R36.2
/PCI/~FRAME: BRIDGE1.U9, PCI0.A34, PCI1.A34, PCI2.A34, PCI3.A34, R27.2
/PCI/~GNT0: BRIDGE1.AB17, PCI0.A17
/PCI/~GNT1: BRIDGE1.AB16, PCI1.A17
/PCI/~GNT2: BRIDGE1.AA14, PCI2.A17
/PCI/~GNT3: BRIDGE1.AB13, PCI3.A17
/PCI/~INT0: BRIDGE1.AA21, PCI0.A6, PCI1.B8, PCI2.A7, PCI3.B7, R29.2
/PCI/~INT1: BRIDGE1.AB21, PCI0.B7, PCI1.A6, PCI2.B8, PCI3.A7, R32.2
/PCI/~INT2: BRIDGE1.AB19, PCI0.A7, PCI1.B7, PCI2.A6, PCI3.B8, R35.2
/PCI/~INT3: BRIDGE1.AA18, PCI0.B8, PCI1.A7, PCI2.B7, PCI3.A6, R38.2
/PCI/~IRDY: BRIDGE1.AB6, PCI0.B35, PCI1.B35, PCI2.B35, PCI3.B35, R33.2
/PCI/~LOCK: BRIDGE1.AB5, PCI0.B39, PCI1.B39, PCI2.B39, PCI3.B39, R37.2
/Power Distrib/BR_TCK: BRIDGE1.G15, J3.6
/Power Distrib/BR_TDI: BRIDGE1.E18, J3.10
/Power Distrib/BR_TDO: BRIDGE1.A19, J3.8
/Power Distrib/BR_TMS: BRIDGE1.C18, J3.4
/Power Distrib/CPU0_TCK: CPU0.G15, J4.6
/Power Distrib/CPU0_TDI: CPU0.E18, J4.10
/Power Distrib/CPU0_TDO: CPU0.A19, J4.8
/Power Distrib/CPU0_TMS: CPU0.C18, J4.4
/Power Distrib/CPU1_TCK: CPU1.G15, J5.6
/Power Distrib/CPU1_TDI: CPU1.E18, J5.10
/Power Distrib/CPU1_TDO: CPU1.A19, J5.8
/Power Distrib/CPU1_TMS: CPU1.C18, J5.4
/Power/3V3SENSE_1: VRM1.A36, W4.2
/Power/3V3SENSE_2: VRM1.A37, W3.2
/Power/5VSENSE_1: VRM1.A13, W2.2
/Power/5VSENSE_2: VRM1.A14, W1.2
/Power/DISCH_1V2: Q19.1, U2.20
/Power/DISCH_1V5: Q7.1, U2.11
/Power/DISCH_3VA: Q3.1, U2.13
/Power/DISCH_3VB: Q8.1, U2.14
/Power/DISCH_5VA: Q15.1, U2.16
/Power/DISCH_5VB: Q16.1, U2.17
/Power/EN_1V2: Q5.3, U2.6, VREG1.5
/Power/EN_1V5: Q6.3, U2.7, VREG2.5
/Power/EN_P12V_PCI: Q4.3, Q18.1, U2.19
/Power/EN_SAFETY: Q4.1, Q5.1, Q6.1, U2.10
/Power/EN_V75: U2.4, U6.9
/Power/EN_V75REF: U2.5, U6.7
/Power/N12VSENSE: VRM1.A44, W5.2
/Power/~EN_P3V3_S0B: Q14.1, U2.15
/Power/~EN_P5V_PCI_B: Q17.1, U2.18
GND: BRIDGE1.A1, BRIDGE1.A22, BRIDGE1.AA5, BRIDGE1.AA9, BRIDGE1.AA13, BRIDGE1.AA17, BRIDGE1.AB1, BRIDGE1.AB22, BRIDGE1.B5, BRIDGE1.B9, BRIDGE1.B13, BRIDGE1.B17, BRIDGE1.D4, BRIDGE1.D18, BRIDGE1.E2, BRIDGE1.E7, BRIDGE1.E11, BRIDGE1.E15, BRIDGE1.E21, BRIDGE1.G5, BRIDGE1.G18, BRIDGE1.H7, BRIDGE1.J2, BRIDGE1.J9, BRIDGE1.J11, BRIDGE1.J13, BRIDGE1.J15, BRIDGE1.J21, BRIDGE1.K10, BRIDGE1.K12, BRIDGE1.K14, BRIDGE1.L5, BRIDGE1.L9, BRIDGE1.L11, BRIDGE1.L13, BRIDGE1.L18, BRIDGE1.M10, BRIDGE1.M12, BRIDGE1.M14, BRIDGE1.N2, BRIDGE1.N9, BRIDGE1.N11, BRIDGE1.N13, BRIDGE1.N17, BRIDGE1.N21, BRIDGE1.P10, BRIDGE1.P12, BRIDGE1.P14, BRIDGE1.R5, BRIDGE1.R18, BRIDGE1.U2, BRIDGE1.U7, BRIDGE1.U21, BRIDGE1.V4, BRIDGE1.V10, BRIDGE1.V14, BRIDGE1.W7, BRIDGE1.W16, BRIDGE1.W19, BT1.2, C3.2, C4.2, C5.2, C6.2, C7.1, C8.1, C9.1, C10.2, C11.2, C12.2, C13.2, C14.2, C15.2, C16.2, C17.2, C18.2, C19.2, C20.2, C21.2, C22.2, C23.2, C24.2, C25.2, C26.2, C27.2, C28.2, C29.2, C30.2, C31.2, C32.2, C33.2, C34.2, C35.2, C36.2, C37.2, C38.2, C39.2, C40.2, C41.2, C42.2, C43.2, C44.2, C45.2, C46.2, C47.2, C48.2, C49.2, C50.2, C51.1, C52.1, C53.1, C54.1, C55.2, C56.2, C57.2, C58.2, C59.2, C60.2, C61.2, C62.2, C63.2, C64.2, C65.2, C66.2, C67.2, C68.2, C69.2, C70.2, C71.2, C72.2, C73.2, C74.2, C75.2, C76.2, C77.2, C78.2, C79.2, C80.2, C81.2, C82.2, C83.2, C84.2, C85.2, C86.2, C87.2, C88.2, C89.2, C90.2, C91.2, C92.2, C93.2, C94.2, C95.2, C96.2, C97.2, C98.2, C99.2, C100.2, C101.2, C102.2, C103.2, C104.2, C105.2, C106.2, C107.2, C108.2, C109.2, C110.2, C111.2, C112.2, C113.2, C114.2, C122.2, C123.2, C124.2, C126.2, C128.1, C129.1, C130.2, CACHE0.12, CACHE0.34, CACHE1.12, CACHE1.34, CPU0.A1, CPU0.A22, CPU0.AA5, CPU0.AA9, CPU0.AA13, CPU0.AA17, CPU0.AB1, CPU0.AB22, CPU0.B5, CPU0.B9, CPU0.B13, CPU0.B17, CPU0.D4, CPU0.D18, CPU0.E2, CPU0.E7, CPU0.E11, CPU0.E15, CPU0.E21, CPU0.G5, CPU0.G18, CPU0.H7, CPU0.J2, CPU0.J9, CPU0.J11, CPU0.J13, CPU0.J15, CPU0.J21, CPU0.K10, CPU0.K12, CPU0.K14, CPU0.L5, CPU0.L9, CPU0.L11, CPU0.L13, CPU0.L18, CPU0.M10, CPU0.M12, CPU0.M14, CPU0.N2, CPU0.N9, CPU0.N11, CPU0.N13, CPU0.N17, CPU0.N21, CPU0.P10, CPU0.P12, CPU0.P14, CPU0.R5, CPU0.R18, CPU0.U2, CPU0.U7, CPU0.U21, CPU0.V4, CPU0.V10, CPU0.V14, CPU0.W7, CPU0.W16, CPU0.W19, CPU1.A1, CPU1.A22, CPU1.AA5, CPU1.AA9, CPU1.AA13, CPU1.AA17, CPU1.AB1, CPU1.AB22, CPU1.B5, CPU1.B9, CPU1.B13, CPU1.B17, CPU1.D4, CPU1.D18, CPU1.E2, CPU1.E7, CPU1.E11, CPU1.E15, CPU1.E21, CPU1.G5, CPU1.G18, CPU1.H7, CPU1.J2, CPU1.J9, CPU1.J11, CPU1.J13, CPU1.J15, CPU1.J21, CPU1.K10, CPU1.K12, CPU1.K14, CPU1.L5, CPU1.L9, CPU1.L11, CPU1.L13, CPU1.L18, CPU1.M10, CPU1.M12, CPU1.M14, CPU1.N2, CPU1.N9, CPU1.N11, CPU1.N13, CPU1.N17, CPU1.N21, CPU1.P10, CPU1.P12, CPU1.P14, CPU1.R5, CPU1.R18, CPU1.U2, CPU1.U7, CPU1.U21, CPU1.V4, CPU1.V10, CPU1.V14, CPU1.W7, CPU1.W16, CPU1.W19, J1.6, J2.6, J2.9, J2.11, J3.1, J3.3, J3.5, J3.7, J3.9, J3.11, J3.13, J4.1, J4.3, J4.5, J4.7, J4.9, J4.11, J4.13, J5.1, J5.3, J5.5, J5.7, J5.9, J5.11, J5.13, J6.3, J6.5, J6.9, J7.2, J8.5, J9.1, J9.3, J9.5, J10.5, LIMB1.2, LIMB1.26, LIMB1.45, LIMB1.70, LIMB1.95, M1.1, MP1.1, MP2.1, MP3.1, MP4.1, PCI0.A18, PCI0.A24, PCI0.A30, PCI0.A35, PCI0.A37, PCI0.A42, PCI0.A48, PCI0.A50, PCI0.A51, PCI0.A56, PCI0.B3, PCI0.B15, PCI0.B17, PCI0.B22, PCI0.B28, PCI0.B34, PCI0.B38, PCI0.B46, PCI0.B50, PCI0.B51, PCI0.B57, PCI1.A18, PCI1.A24, PCI1.A30, PCI1.A35, PCI1.A37, PCI1.A42, PCI1.A48, PCI1.A50, PCI1.A51, PCI1.A56, PCI1.B3, PCI1.B15, PCI1.B17, PCI1.B22, PCI1.B28, PCI1.B34, PCI1.B38, PCI1.B46, PCI1.B50, PCI1.B51, PCI1.B57, PCI2.A18, PCI2.A24, PCI2.A30, PCI2.A35, PCI2.A37, PCI2.A42, PCI2.A48, PCI2.A50, PCI2.A51, PCI2.A56, PCI2.B3, PCI2.B15, PCI2.B17, PCI2.B22, PCI2.B28, PCI2.B34, PCI2.B38, PCI2.B46, PCI2.B50, PCI2.B51, PCI2.B57, PCI3.A18, PCI3.A24, PCI3.A30, PCI3.A35, PCI3.A37, PCI3.A42, PCI3.A48, PCI3.A50, PCI3.A51, PCI3.A56, PCI3.B3, PCI3.B15, PCI3.B17, PCI3.B22, PCI3.B28, PCI3.B34, PCI3.B38, PCI3.B46, PCI3.B50, PCI3.B51, PCI3.B57, Q3.2, Q4.2, Q5.2, Q6.2, Q7.2, Q8.2, Q14.2, Q15.2, Q16.2, Q17.2, Q18.2, Q19.2, R1.2, R3.1, R22.2, R52.2, R57.2, R58.2, R59.2, R60.2, R61.2, R87.2, R90.1, R91.1, R92.2, R93.2, R94.2, SODIMM1.2, SODIMM1.3, SODIMM1.8, SODIMM1.9, SODIMM1.13, SODIMM1.14, SODIMM1.19, SODIMM1.20, SODIMM1.25, SODIMM1.26, SODIMM1.31, SODIMM1.32, SODIMM1.37, SODIMM1.38, SODIMM1.43, SODIMM1.44, SODIMM1.48, SODIMM1.49, SODIMM1.54, SODIMM1.55, SODIMM1.60, SODIMM1.61, SODIMM1.65, SODIMM1.66, SODIMM1.71, SODIMM1.72, SODIMM1.127, SODIMM1.128, SODIMM1.133, SODIMM1.134, SODIMM1.138, SODIMM1.139, SODIMM1.144, SODIMM1.145, SODIMM1.150, SODIMM1.151, SODIMM1.155, SODIMM1.156, SODIMM1.161, SODIMM1.162, SODIMM1.167, SODIMM1.168, SODIMM1.172, SODIMM1.173, SODIMM1.178, SODIMM1.179, SODIMM1.184, SODIMM1.185, SODIMM1.189, SODIMM1.190, SODIMM1.195, SODIMM1.196, SW1.1, SW1.2, SW2.1, SW2.2, SW3.1, SW3.2, SW3.3, SW3.4, U1.1, U1.18, U1.33, U2.12, U3.4, U3.9, U4.2, U4.4, U5.5, U5.10, U6.4, U6.8, U6.11, U7.4, U7.5, U7.6, U7.7, U8.4, U8.5, U8.6, U9.2, U10.15, U11.2, VREG1.3, VREG2.3, VRM1.A1, VRM1.A2, VRM1.A3, VRM1.A4, VRM1.A5, VRM1.A6, VRM1.A7, VRM1.A8, VRM1.A9, VRM1.A10, VRM1.A11, VRM1.A12, VRM1.A15, VRM1.A16, VRM1.A17, VRM1.A18, VRM1.A19, VRM1.A20, VRM1.A21, VRM1.A22, VRM1.A23, VRM1.A24, VRM1.A25, VRM1.A26, VRM1.A27, VRM1.A28, VRM1.A29, VRM1.A30, VRM1.A31, VRM1.A32, VRM1.A33, VRM1.A34, VRM1.A35, VRM1.A38, VRM1.A39, VRM1.A40, VRM1.A41, VRM1.A42, VRM1.A43, VRM1.A45, VRM1.A46, VRM1.B46, VRM1.B47, VRM1.B48, VRM1.B49, X1.3, X2.3
N12V_PCI: C51.2, C52.2, C53.2, C54.2, JP7.2, PCI0.B1, PCI1.B1, PCI2.B1, PCI3.B1
unnamed: BT1.1, C87.1, U3.3
unnamed: C1.1, Q1.2, Q2.2, R2.1
unnamed: C1.2, C2.2, Q1.1, Q2.1, R1.1, R2.2
unnamed: C55.1, E1.2, VREG1.4
unnamed: C56.1, E2.2, VREG2.4
unnamed: C83.1, C84.1, C85.1, C86.1, R85.1, U3.8
unnamed: C89.1, U4.5, U5.3
unnamed: C122.1, R14.2
unnamed: C125.1, U10.4
unnamed: C125.2, U10.5
unnamed: C126.1, U10.6
unnamed: C127.1, U10.3
unnamed: C127.2, U10.1
unnamed: C128.2, U10.2
unnamed: DS19.1, R22.1
unnamed: DS20.1, R52.1
unnamed: J1.1, U1.7
unnamed: J1.5, R7.2, U1.8
unnamed: J8.1, R3.2, R4.2, U9.5
unnamed: J9.6, R71.2, R73.2, SW1.3, SW1.4
unnamed: JP1.1, R77.1
unnamed: JP2.1, R78.4
unnamed: JP3.1, R79.4
unnamed: JP7.1, R80.1
unnamed: JP8.1, R81.1
unnamed: JP9.1, R82.4
unnamed: JP10.1, JP11.1, R83.1
unnamed: JP12.1, R84.4
unnamed: LIMB1.11, LIMB1.16, LIMB1.36, LIMB1.56, LIMB1.85, LIMB1.100
unnamed: Q3.3, R65.2
unnamed: Q7.3, R67.2
unnamed: Q8.3, R66.2
unnamed: Q9.3, R77.2
unnamed: Q10.1, Q17.3, R75.2
unnamed: Q10.2, R70.1, R79.1
unnamed: Q11.1, Q14.3, R76.2
unnamed: Q11.2, R66.1, R83.2, R84.1
unnamed: Q15.3, R63.2
unnamed: Q16.3, R64.2
unnamed: Q9.1, Q18.3, R68.2
unnamed: Q19.3, R62.2
unnamed: R5.1, U1.20
unnamed: R6.1, U1.19
unnamed: R10.2, U1.14
unnamed: R11.2, U1.28
unnamed: R12.2, U1.13
unnamed: R13.2, U1.27
unnamed: R15.2, U1.12
unnamed: R16.2, U1.26
unnamed: R18.2, U1.11
unnamed: R19.2, U1.25
unnamed: R20.2, U1.10
unnamed: R21.2, U1.24
unnamed: R50.2, U1.9
unnamed: R51.2, U1.23
unnamed: R53.2, U1.22
unnamed: R54.2, U1.21
unnamed: R57.1, VREG1.2
unnamed: R58.1, VREG2.2
unnamed: R59.1, U2.2
unnamed: R60.1, U2.21
unnamed: R61.1, U2.3
unnamed: R63.1, R69.2
unnamed: R64.1, R70.2
unnamed: R72.2, R74.2, SW2.3, SW2.4
unnamed: R88.2, U5.9
unnamed: R89.2, U5.8
unnamed: U3.1, X1.1
unnamed: U3.2, X1.2
unnamed: U5.1, X2.1
unnamed: U5.14, X2.2
P1V2_CORE: BRIDGE1.J8, BRIDGE1.J10, BRIDGE1.J12, BRIDGE1.J14, BRIDGE1.K9, BRIDGE1.K11, BRIDGE1.K13, BRIDGE1.L10, BRIDGE1.L12, BRIDGE1.L14, BRIDGE1.M9, BRIDGE1.M11, BRIDGE1.M13, BRIDGE1.N10, BRIDGE1.N12, BRIDGE1.N14, BRIDGE1.P9, BRIDGE1.P11, BRIDGE1.P13, BRIDGE1.R14, C80.1, C90.1, C91.1, C92.1, C93.1, C94.1, C95.1, C96.1, C97.1, CPU0.J8, CPU0.J10, CPU0.J12, CPU0.J14, CPU0.K9, CPU0.K11, CPU0.K13, CPU0.L10, CPU0.L12, CPU0.L14, CPU0.M9, CPU0.M11, CPU0.M13, CPU0.N10, CPU0.N12, CPU0.N14, CPU0.P9, CPU0.P11, CPU0.P13, CPU0.R14, CPU1.J8, CPU1.J10, CPU1.J12, CPU1.J14, CPU1.K9, CPU1.K11, CPU1.K13, CPU1.L10, CPU1.L12, CPU1.L14, CPU1.M9, CPU1.M11, CPU1.M13, CPU1.N10, CPU1.N12, CPU1.N14, CPU1.P9, CPU1.P11, CPU1.P13, CPU1.R14, JP6.2
P1V5_BRIDGE: BRIDGE1.B4, BRIDGE1.B7, BRIDGE1.B11, BRIDGE1.B15, BRIDGE1.B19, BRIDGE1.C2, BRIDGE1.C21, BRIDGE1.E9, BRIDGE1.E13, BRIDGE1.E17, BRIDGE1.E19, BRIDGE1.F4, BRIDGE1.F6, BRIDGE1.G2, BRIDGE1.G10, BRIDGE1.G14, BRIDGE1.G21, BRIDGE1.J5, BRIDGE1.J18, BRIDGE1.L2, BRIDGE1.L7, BRIDGE1.L16, BRIDGE1.L21, BRIDGE1.N5, BRIDGE1.N18, BRIDGE1.R2, BRIDGE1.R21, BRIDGE1.U5, BRIDGE1.U18, BRIDGE1.W2, BRIDGE1.W21, C10.1, C11.1, C12.1, C14.1, C15.1, C16.1, C18.1, C19.1, C20.1, C22.1, C23.1, C24.1, C26.1, C27.1, C28.1, C30.1, C31.1, C32.1, C81.1, C98.1, C99.1, C100.1, C101.1, C102.1, C103.1, C104.1, C105.1, C111.1, CPU0.C2, CPU0.F4, CPU0.F6, CPU0.G2, CPU0.J5, CPU0.L2, CPU0.L7, CPU0.N5, CPU0.R2, CPU0.U5, CPU0.W2, CPU1.C2, CPU1.F4, CPU1.F6, CPU1.G2, CPU1.J5, CPU1.L2, CPU1.L7, CPU1.N5, CPU1.R2, CPU1.U5, CPU1.W2, JP4.2, SODIMM1.75, SODIMM1.76, SODIMM1.81, SODIMM1.82, SODIMM1.87, SODIMM1.88, SODIMM1.93, SODIMM1.94, SODIMM1.99, SODIMM1.100, SODIMM1.105, SODIMM1.106, SODIMM1.111, SODIMM1.112, SODIMM1.117, SODIMM1.118, SODIMM1.123, SODIMM1.124, U6.1, U6.2
P3V3_AUX: C29.1, C88.1, C123.1, C124.1, JP8.2, Q12.1, Q13.1, Q20.1, Q21.1, R41.1, R42.1, R43.1, R44.1, R45.1, R46.1, R47.1, R48.1, R49.2, R55.1, R86.1, R95.1, R96.1, R97.1, SODIMM1.199, U4.1, U4.3, U5.6, U5.7, U7.8, U8.7, U8.8, U11.5
P3V3_BRIDGE: BRIDGE1.AA3, BRIDGE1.AA7, BRIDGE1.AA11, BRIDGE1.AA15, BRIDGE1.AA19, BRIDGE1.D16, BRIDGE1.F11, BRIDGE1.G12, BRIDGE1.H9, BRIDGE1.H15, BRIDGE1.K15, BRIDGE1.L8, BRIDGE1.M15, BRIDGE1.N8, BRIDGE1.R6, BRIDGE1.R10, BRIDGE1.R12, BRIDGE1.T9, BRIDGE1.T13, BRIDGE1.U11, BRIDGE1.V6, BRIDGE1.V8, BRIDGE1.V12, BRIDGE1.V16, BRIDGE1.W5, C106.1, C107.1, C108.1, C109.1, C110.1, C115.1, C116.2, C117.2, C118.2, C119.2, C120.2, C121.2, J3.2, JP10.2, R27.1, R28.1, R29.1, R30.1, R31.1, R32.1, R33.1, R34.1, R35.1, R36.1, R37.1, R38.1, U6.10
P3V3_CPU: C75.1, C76.1, C77.1, C78.1, C79.1, CACHE0.11, CACHE0.33, CACHE1.11, CACHE1.33, CPU0.AA3, CPU0.AA7, CPU0.AA11, CPU0.AA15, CPU0.AA19, CPU0.C21, CPU0.D16, CPU0.E19, CPU0.F11, CPU0.G12, CPU0.G21, CPU0.H9, CPU0.H15, CPU0.J18, CPU0.K15, CPU0.L8, CPU0.L16, CPU0.L21, CPU0.M15, CPU0.N8, CPU0.N18, CPU0.R6, CPU0.R10, CPU0.R12, CPU0.R21, CPU0.T9, CPU0.T13, CPU0.U11, CPU0.U18, CPU0.V6, CPU0.V8, CPU0.V12, CPU0.V16, CPU0.W5, CPU0.W21, CPU1.AA3, CPU1.AA7, CPU1.AA11, CPU1.AA15, CPU1.AA19, CPU1.C21, CPU1.D16, CPU1.E19, CPU1.F11, CPU1.G12, CPU1.G21, CPU1.H9, CPU1.H15, CPU1.J18, CPU1.K15, CPU1.L8, CPU1.L16, CPU1.L21, CPU1.M15, CPU1.N8, CPU1.N18, CPU1.R6, CPU1.R10, CPU1.R12, CPU1.R21, CPU1.T9, CPU1.T13, CPU1.U11, CPU1.U18, CPU1.V6, CPU1.V8, CPU1.V12, CPU1.V16, CPU1.W5, CPU1.W21, J4.2, J5.2, JP11.2
P3V3_PCI_A: C37.1, C38.1, C45.1, C46.1, C118.1, C120.1, C121.1, JP9.2, PCI0.A10, PCI0.A14, PCI0.A16, PCI0.A21, PCI0.A27, PCI0.A33, PCI0.A39, PCI0.A45, PCI0.A53, PCI0.A59, PCI0.B19, PCI0.B25, PCI0.B31, PCI0.B36, PCI0.B41, PCI0.B43, PCI0.B54, PCI0.B59, PCI2.A10, PCI2.A14, PCI2.A16, PCI2.A21, PCI2.A27, PCI2.A33, PCI2.A39, PCI2.A45, PCI2.A53, PCI2.A59, PCI2.B19, PCI2.B25, PCI2.B31, PCI2.B36, PCI2.B41, PCI2.B43, PCI2.B54, PCI2.B59
P3V3_PCI_B: C41.1, C42.1, C49.1, C50.1, C116.1, C117.1, C119.1, JP12.2, PCI1.A10, PCI1.A14, PCI1.A16, PCI1.A21, PCI1.A27, PCI1.A33, PCI1.A39, PCI1.A45, PCI1.A53, PCI1.A59, PCI1.B19, PCI1.B25, PCI1.B31, PCI1.B36, PCI1.B41, PCI1.B43, PCI1.B54, PCI1.B59, PCI3.A10, PCI3.A14, PCI3.A16, PCI3.A21, PCI3.A27, PCI3.A33, PCI3.A39, PCI3.A45, PCI3.A53, PCI3.A59, PCI3.B19, PCI3.B25, PCI3.B31, PCI3.B36, PCI3.B41, PCI3.B43, PCI3.B54, PCI3.B59
P3V3_STBY: C7.2, C8.2, C82.1, C115.2, C129.2, J1.2, J6.1, JP13.2, LIMB1.10, LIMB1.27, LIMB1.50, LIMB1.69, LIMB1.91, LIMB1.98, R7.1, R8.1, R9.1, R85.2, U1.17, U1.32, U2.24, U10.16
P5V_PCI_A: C36.1, C44.1, C71.1, C73.1, JP2.2, PCI0.A5, PCI0.A8, PCI0.A61, PCI0.A62, PCI0.B5, PCI0.B6, PCI0.B61, PCI0.B62, PCI2.A5, PCI2.A8, PCI2.A61, PCI2.A62, PCI2.B5, PCI2.B6, PCI2.B61, PCI2.B62
P5V_PCI_B: C40.1, C48.1, C72.1, C74.1, JP3.2, PCI1.A5, PCI1.A8, PCI1.A61, PCI1.A62, PCI1.B5, PCI1.B6, PCI1.B61, PCI1.B62, PCI3.A5, PCI3.A8, PCI3.A61, PCI3.A62, PCI3.B5, PCI3.B6, PCI3.B61, PCI3.B62
P12V_PCI: C35.1, C39.1, C43.1, C47.1, C130.1, JP1.2, M1.2, PCI0.A2, PCI1.A2, PCI2.A2, PCI3.A2
PV75_SDRAM_VREF: C13.1, C17.1, C112.1, SODIMM1.1, SODIMM1.126, U6.6
PV75_SDRAM_VTT: C21.1, C25.1, C113.1, C114.1, SODIMM1.203, SODIMM1.204, U6.3, U6.5
SBY_P3V3: R71.1, R72.1
VDDRREF: BRIDGE1.A4, BRIDGE1.A9, BRIDGE1.A13, BRIDGE1.B3, BRIDGE1.B20, BRIDGE1.C16, BRIDGE1.M4, BRIDGE1.N19, BRIDGE1.Y1
