c4puter/motherboard/(commit log)

2016-07-06 Finish power supplies
    [Power.sch, c4puter.kicad_pcb]
2016-07-06 Upgrade FPGA size, re-route SDRAM
    [Multibridge.sch, PDist.sch, PerBus.sch, c4puter.kicad_pcb]
2016-07-06 Begin implementing PCI
    [EC.sch, Multibridge.sch, PDist.sch, PerBus.sch, Power.sch, c4puter.kicad_pcb]
2016-07-06 PCI bus decoupling
    [PerBus.sch, Power.sch, c4puter.kicad_pcb]
2016-07-06 Begin replacing power supply
    [Power.sch]
2016-07-06 Continue routing PCI
    [PerBus.sch, Power.sch, c4puter.kicad_pcb]
2016-07-06 More PCI work
    [PerBus.sch, Power.sch, c4puter.kicad_pcb]
2016-07-06 More power supply work
    [CPUn.sch, EC.sch, Multibridge.sch, PDist.sch, PerBus.sch, Power.sch, c4puter.kicad_pcb, c4puter.sch]
2016-07-06 Uh, more misc work.
    [Blinkenlights.sch, CPUn.sch, EC.sch, Multibridge.sch, PDist.sch, PerBus.sch, Power.sch, c4puter.kicad_pcb]
2016-07-07 MOAR WORK
    [Blinkenlights.sch, EC.sch, PDist.sch, PerBus.sch, Power.sch, c4puter.kicad_pcb, c4puter.sch]
2016-07-09 MOAR WORK, v2
    [EC.sch, Multibridge.sch, PerBus.sch, c4puter.kicad_pcb, c4puter.sch]
2016-07-09 Rip up SDRAM and rotate FPGA
    [Blinkenlights.sch, CPUn.sch, EC.sch, Multibridge.sch, PDist.sch, PerBus.sch, Power.sch, c4puter.kicad_pcb]
2016-07-10 Reroute SDRAM after bank swap
    [Blinkenlights.sch, CPUn.sch, EC.sch, Multibridge.sch, PDist.sch, PerBus.sch, Power.sch, c4puter.kicad_pcb]
2016-07-10 Route EC and half of PCI bus to bridge
    [Multibridge.sch, c4puter.kicad_pcb]
2016-07-10 Finish routing PCI
    [Multibridge.sch, c4puter.kicad_pcb]
2016-07-10 Break out CPU bus
    [Multibridge.sch, c4puter.kicad_pcb]
2016-07-24 Route CPU bus and cache
    [Blinkenlights.sch, CPUn.sch, EC.sch, Multibridge.sch, PCI.sch, PDist.sch, Power.sch, c4puter.kicad_pcb]
2016-07-29 power, yo
    [Blinkenlights.sch, CPUn.sch, EC.sch, Misc.sch, Multibridge.sch, PCI.sch, PDist.sch, Power.sch]
2016-08-01 TODO: learn to write good commit messages
    [Blinkenlights.sch, CPUn.sch, EC.sch, Misc.sch, Multibridge.sch, PCI.sch, PDist.sch, Power.sch]
2016-08-01 Rearrange power control circuit
    [Power.sch, c4puter.kicad_pcb]
2016-08-02 Route clocks
    [Blinkenlights.sch, CPUn.sch, EC.sch, Misc.sch, Multibridge.sch, Power.sch, c4puter.kicad_pcb, c4puter.sch]
2016-08-02 Proper coin cell holder
    [Misc.sch, c4puter.kicad_pcb]
2016-08-03 MOAR ROUTING
    [c4puter.kicad_pcb]
2016-08-03 Change USB input circuit
    [CPUn.sch, EC.sch, c4puter.kicad_pcb]
2016-08-04 Add RS-232
    [Blinkenlights.sch, CPUn.sch, EC.sch, Misc.sch, Multibridge.sch, Power.sch, c4puter.kicad_pcb]
2016-08-05 Add CPU fan
    [Blinkenlights.sch, CPUn.sch, EC.sch, Misc.sch, Multibridge.sch, Power.sch, c4puter.kicad_pcb]
2016-08-05 Add SDRAM SPD to I2C
    [EC.sch, Multibridge.sch, c4puter.kicad_pcb, c4puter.sch]
2016-08-05 Replace ULN2003 with FETs
    [Blinkenlights.sch, CPUn.sch, EC.sch, Misc.sch, Multibridge.sch, Power.sch, c4puter.kicad_pcb]
2016-08-05 Route PCI SMBUS
    [EC.sch, PCI.sch, Power.sch, c4puter.kicad_pcb, c4puter.sch]
2016-08-05 Route PCI utility lines
    [EC.sch, Multibridge.sch, c4puter.kicad_pcb, c4puter.sch]
2016-08-05 Add configuration pullup resistors
    [CPUn.sch, EC.sch, Multibridge.sch, PDist.sch]
2016-08-05 Tidy up page Power
    [Power.sch]
2016-08-06 Tidy up Power Distribution page
    [CPUn.sch, Multibridge.sch, PDist.sch]
2016-08-06 Approve PCI page with no tidying
    [Multibridge.sch, PCI.sch]
2016-08-06 Tidy up Northbridge sheet
    [Northbridge.sch]
2016-08-06 Tidy up Misc sheet
    [Misc.sch]
2016-08-06 Tidy up EC sheet
    [EC.sch, c4puter.sch]
2016-08-06 Rename EC sheet to LIMB
    [LIMB.sch, c4puter.sch]
2016-08-06 Tidy up CPU sheet
    [CPUn.sch]
2016-08-06 Tidy up Blinkenlights sheet
    [Blinkenlights.sch]
2016-08-06 Tidy up root sheet
    [c4puter.sch]
2016-08-06 Fix voltage regulator trim resistors
    [Blinkenlights.sch, CPUn.sch, LIMB.sch, Misc.sch, Northbridge.sch, PDist.sch, Power.sch, motherboard.sch]
2016-08-06 Remove unneeded discharge FETs
    PCF8575 can sink the current directly
    [Power.sch]
2016-08-06 Finish adding config interface pullups
    [Blinkenlights.sch, CPUn.sch, LIMB.sch, Misc.sch, Northbridge.sch, Power.sch]
2016-08-06 Route FPGA suspend signals
    [Blinkenlights.sch, CPUn.sch, LIMB.sch, Misc.sch, Northbridge.sch, Power.sch, motherboard.sch]
2016-08-06 Add inter-CPU handshake lines
    [CPUn.sch, motherboard.sch]
2016-08-06 Move voltage sense to after power routing
2016-08-06 Fix footprint errors and adjust DE-9 footprint
    [Northbridge.sch, PDist.sch, motherboard.sch]
2016-08-06 Check SD and power footprints
    [motherboard.sch]
2016-08-06 Finish LIMB-SD interface
    [CPUn.sch, LIMB.sch]
2016-08-06 Switch resistors to 0402
    [Blinkenlights.sch, CPUn.sch, Misc.sch, PCI.sch, Power.sch, motherboard.sch]
2016-08-07 Label LIMB sheet
    [LIMB.sch]
2016-08-08 Rename active-low signals for consistency
    [CPUn.sch, Northbridge.sch, PCI.sch, motherboard.sch]
2016-08-08 Connect SDRAM EVENT# line
    [LIMB.sch, Northbridge.sch, PDist.sch, motherboard.sch]
2016-08-08 Route unused PCI JTAG lines
    [Blinkenlights.sch, CPUn.sch, LIMB.sch, Misc.sch, Northbridge.sch, PCI.sch, Power.sch]
2016-08-10 Add voltage reference
    [LIMB.sch, Northbridge.sch]
2016-08-10 Gather and assign all I2C addresses
    [Blinkenlights.sch, CPUn.sch, Misc.sch, Power.sch]
2016-08-10 Route I2C to CPUs for debug/boot control
    This will provide an interface for the LIMB to write to CPU registers, which
    will be required at least for configuring the program counter at boot.
    [CPUn.sch, motherboard.sch]
2016-08-11 Set I2C pullups
    [LIMB.sch]
2016-08-11 Switch to 8-position DIP switch
    [CPUn.sch, motherboard.sch]
2016-08-11 Put clock battery at 180deg orientation for mewyn.
2016-08-11 Add high-speed termination to FPGA config data
    Simulation shows this damping refections.
    [Blinkenlights.sch, CPUn.sch, LIMB.sch, Misc.sch, Northbridge.sch, PCI.sch, PDist.sch, Power.sch]
2016-08-11 Connect RTC alarm interrupt
    [LIMB.sch, Misc.sch, motherboard.sch]
2016-08-11 Add power connector for storage device
    [Blinkenlights.sch, CPUn.sch, LIMB.sch, Misc.sch, Northbridge.sch, PCI.sch, PDist.sch, Power.sch]
2016-08-11 Set DIP switch part number and courtyard
    [motherboard.sch]
2016-08-11 IO expander for switches/buttons/LEDs
    [Blinkenlights.sch, CPUn.sch, LIMB.sch, Misc.sch, Northbridge.sch, PCI.sch, PDist.sch, Power.sch]
2016-08-11 Route P3V3_SUSP
    [LIMB.sch, Northbridge.sch]
2016-08-11 Route P3V3_AUX and some ground
    [CPUn.sch, LIMB.sch, Misc.sch, Northbridge.sch, motherboard.sch]
2016-08-11 Route P3V3_BRIDGE
    [PCI.sch]
2016-08-11 Route ground
2016-08-11 Route ground, some routing cleanups
    [PCI.sch, motherboard.sch]
2016-08-12 CPU decoupling
    [Blinkenlights.sch, CPUn.sch, LIMB.sch, Misc.sch, Northbridge.sch, PCI.sch, PDist.sch, Power.sch]
2016-08-12 More power/decoupling
    [Blinkenlights.sch, CPUn.sch, LIMB.sch, Misc.sch, Northbridge.sch, PCI.sch, PDist.sch, Power.sch]
2016-08-12 Add CPUID resistors
    [Blinkenlights.sch, CPUn.sch, LIMB.sch, Misc.sch, Northbridge.sch, PCI.sch, PDist.sch, Power.sch]
2016-08-12 Route and decouple SDRAM VREF for bridge
    [CPUn.sch, Northbridge.sch]
2016-08-12 Add voltage sense for several rails
    [LIMB.sch, Northbridge.sch]
2016-08-12 Run ERC and connect missing D6
    [Blinkenlights.sch, CPUn.sch, LIMB.sch, Misc.sch, Northbridge.sch, PCI.sch, PDist.sch, Power.sch]
2016-08-12 Ground plane touchups
2016-08-12 Add more mounting holes
    [Blinkenlights.sch, CPUn.sch, LIMB.sch, Misc.sch, Northbridge.sch, PCI.sch, PDist.sch, Power.sch]
2016-08-12 Renumber sheets
    [Blinkenlights.sch, CPUn.sch, LIMB.sch, Misc.sch, Northbridge.sch, PCI.sch, PDist.sch, Power.sch]
2016-08-13 Squiggles! Silk!
    [Blinkenlights.sch, CPUn.sch, LIMB.sch, Misc.sch, Northbridge.sch, PCI.sch, PDist.sch, Power.sch]
2016-08-13 Initial BOM
    [LIMB.sch, motherboard.sch]
2016-08-14 Final BOM
    [Blinkenlights.sch, CPUn.sch, LIMB.sch, Misc.sch, Northbridge.sch, PCI.sch, PDist.sch, Power.sch]
2016-08-14 Add damping resistor to power input circuit
    [CPUn.sch, motherboard.sch]
2016-08-16 Fuck. Rip up bridge.
    [PDist.sch]
2016-08-19 Remove current sense resistors, add I2C debug header
    [Northbridge.sch, Power.sch, motherboard.sch]
2016-08-19 Via stitching around ground input
2016-08-20 Switch LED metrix driver
    [Blinkenlights.sch, CPUn.sch, LIMB.sch, Misc.sch, Northbridge.sch, PCI.sch, PDist.sch, Power.sch]
2016-08-21 sdram weeeee
    [Northbridge.sch]
2016-08-23 Reroute CPU bus
    [Northbridge.sch, motherboard.sch]
2016-08-25 Route some PCIs
    [Northbridge.sch]
2016-08-28 Route PCI bus. again.
    [Northbridge.sch]
2016-08-31 Finish most redone routing
    [LIMB.sch, Northbridge.sch, Power.sch]
2016-08-31 Adjust aux signals, tune FPGA config track lengths
2016-08-31 Fixup PCI power
2016-08-31 Hide silkscreen for 0201 capacitors
2016-08-31 Add some test points
    [CPUn.sch, LIMB.sch, Misc.sch, Power.sch, motherboard.sch]
2016-08-31 Add ground clips
    [motherboard.sch]
2016-09-01 Rearrange LEDs a bit, switch to al-poly caps
    [Blinkenlights.sch, PDist.sch, motherboard.sch]
2016-09-01 Fix more shit for to pass ERC
    [Blinkenlights.sch, CPUn.sch, LIMB.sch, Misc.sch, Northbridge.sch, PCI.sch, PDist.sch, Power.sch]
2016-09-04 Fix fuckup 2: bank 0 ain't got no SSTL
    [Northbridge.sch]
2016-09-04 Add power input protection
    - Add a fast-blow 6A fuse
    - Specify an optional slow-blow if the fast-blow blows
    - Add snubber near input to damp resonances and prevent spikes
    [Blinkenlights.sch, CPUn.sch, LIMB.sch, Misc.sch, Northbridge.sch, PCI.sch, PDist.sch, Power.sch]
2016-09-05 Tidy up a bit
    [motherboard.sch]
2016-09-05 Final touchup, DRC, render for fab
    [Northbridge.sch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]
2016-09-06 Fucking KiCad
    [motherboard-B.Cu.gbl, motherboard-B.Mask.gbs, motherboard-B.SilkS.gbo, motherboard-Edge.Cuts.gm1, motherboard-F.Cu.gtl, motherboard-F.Mask.gts, motherboard-F.Paste.gtp, motherboard-F.SilkS.gto]
2016-09-16 Prepare assembly diagram
2016-09-16 Tidy schematics and produce PDF
    [Blinkenlights.sch, CPUn.sch, LIMB.sch, Misc.sch, Northbridge.sch, PCI.sch, PDist.sch, Power.sch]
2017-11-18 Update for KiCad 5
    [Blinkenlights.sch, CPUn.sch, LIMB.sch, Misc.sch, Northbridge.sch, PCI.sch, PDist.sch, Power.sch]
2017-11-18 Fix IO expanders (symbol changed in library)
    [Misc.sch, Power.sch, motherboard.sch]
2017-11-18 Update schematic to reflect modifications
    [Blinkenlights.sch, CPUn.sch, LIMB.sch, Misc.sch, Northbridge.sch, PCI.sch, PDist.sch, Power.sch]
2017-12-02 Fix LED address
    [Blinkenlights.sch, motherboard.sch]
